teoteo/Wheelly/driver/indi-wheelly/upstream/CMakeLists-indi.txt

# SPDX-FileCopyrightText: 2026 Matteo Beretta
# SPDX-License-Identifier: LGPL-2.1-or-later
#
# The lines to_indi.py appends to indilib/indi's drivers/filter_wheel/
# CMakeLists.txt - everything from the banner below to the end of this file.
# The @...@ fields are filled by to_indi.py from this folder's CMakeLists.txt,
# so the version proposed to INDI cannot fall behind the driver's own. Not
# used by this repository's build.
#
# Modelled on the filter wheels already there - xagyl_wheel, rasa_filtercube:
# one executable linked to indidriver, installed to bin - and on the Shelyak
# driver in drivers/spectrograph/, which keeps its sources in a subfolder and
# names them from the category's CMakeLists.txt, without a CMakeLists.txt of
# its own. A subfolder because the driver brings its own protocol header and
# a configured header template, which belong together and would be the only
# ones of their kind loose in a folder shared by fifteen drivers.

# ############### Wheelly Filter Wheel ################
set(WHEELLY_VERSION_MAJOR @WHEELLY_VERSION_MAJOR@)
set(WHEELLY_VERSION_MINOR @WHEELLY_VERSION_MINOR@)
set(WHEELLY_DEVICE_NAME "Wheelly")
configure_file(${CMAKE_CURRENT_SOURCE_DIR}/wheelly/wheelly_config.h.cmake
               ${CMAKE_CURRENT_BINARY_DIR}/wheelly/wheelly_config.h)

SET(wheelly_SRC
    ${CMAKE_CURRENT_SOURCE_DIR}/wheelly/wheelly.cpp)

add_executable(@WHEELLY_EXECUTABLE@ ${wheelly_SRC})
target_include_directories(@WHEELLY_EXECUTABLE@ PRIVATE
    ${CMAKE_CURRENT_SOURCE_DIR}/wheelly
    ${CMAKE_CURRENT_BINARY_DIR}/wheelly)
target_link_libraries(@WHEELLY_EXECUTABLE@ indidriver)
install(TARGETS @WHEELLY_EXECUTABLE@ RUNTIME DESTINATION bin)
