teoteo/Wheelly/brand/png/wheelly-mark-3x.png

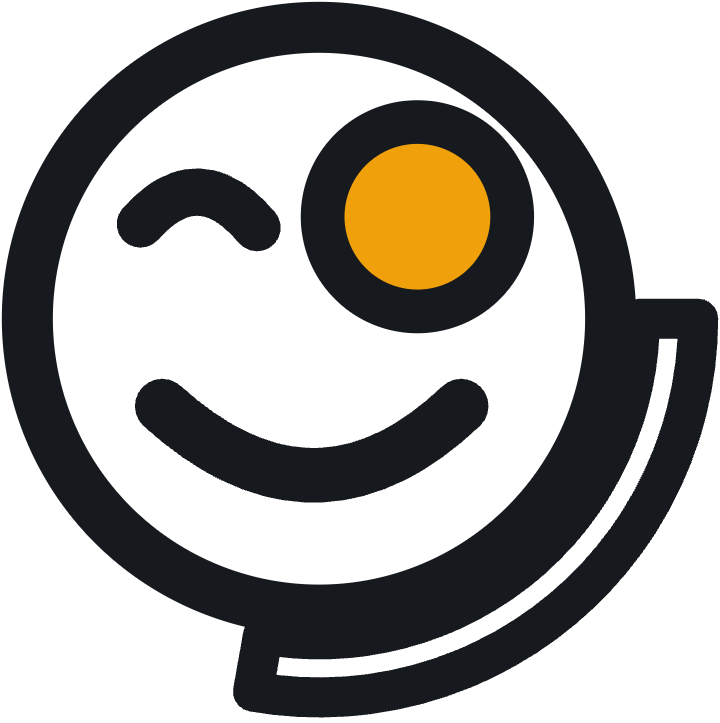
brand/png/wheelly-mark-3x.png
