teoteo/Wheelly/brand/png/wheelly-mark-mono-paper-3x.png

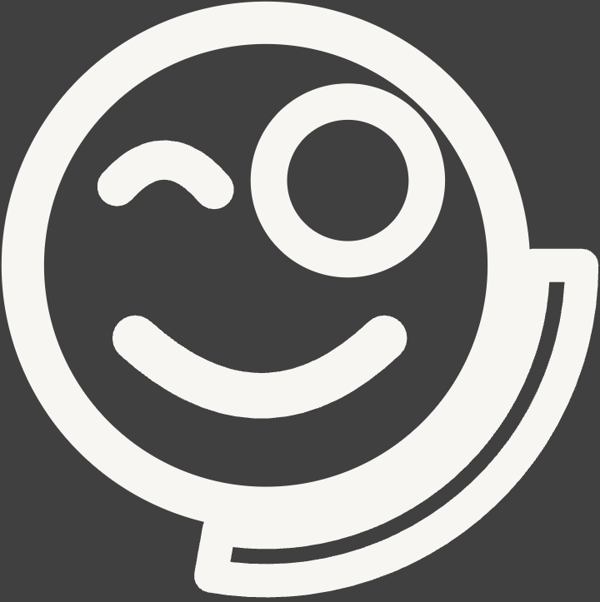
brand/png/wheelly-mark-mono-paper-3x.png
