teoteo/Wheelly/brand/png/wheelly-mark-reversed-3x.png

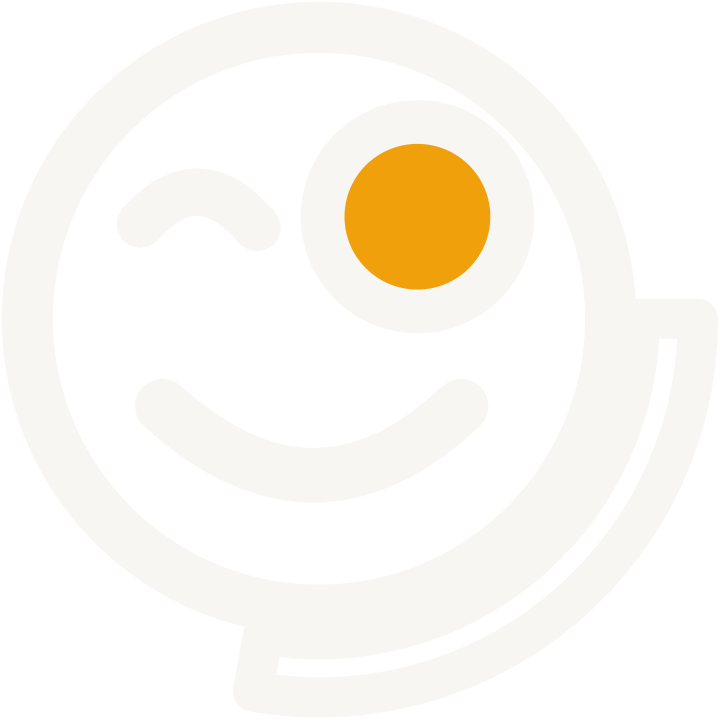
brand/png/wheelly-mark-reversed-3x.png
