teoteo/Wheelly/driver/indi-wheelly/upstream/doc/wheelly.webp

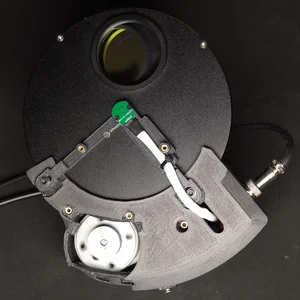
driver/indi-wheelly/upstream/doc/wheelly.webp
