teoteo/Wheelly/docs/assembly/README.md

<!--
SPDX-FileCopyrightText: 2026 Matteo Beretta
SPDX-License-Identifier: CC-BY-4.0
-->

*[Leggi in italiano](it/README.md)*

# Wheelly — assembly guide

A motorised filter wheel, built from a manual one. Work through the chapters in order: each one lists the parts and the tools it needs before its first step.

**The published guide is the site** — open `index.html` here, or the GitHub Pages address of this repository. The Markdown files below are the same chapters, kept so they can be read and diffed inside GitHub.

Every picture in this guide is rendered from the CAD model itself, so it cannot show a machine different from the one you printed. **Each part keeps the same colour from the first step to the last.**

| | Chapter | |
|---:|---|---|
| 0 | [Parts, tools and printing](00-parts-tools-and-printing.md) | [as a page](00-parts-tools-and-printing.html) · the general bill of materials, what to print and how |
| 1 | [Making it fit your wheel](01-the-parameters-page.md) | [as a page](01-the-parameters-page.html) · the parameters page: skip it if your wheel is the reference one |
| 2 | [Heat-set inserts](02-heat-set-inserts.md) | [as a page](02-heat-set-inserts.html) · all the inserts, in the order that keeps the iron reachable |
| 3 | [The collar and its gaskets](03-collar-and-gaskets.md) | [as a page](03-collar-and-gaskets.html) |
| 4 | [The spring and the connector, before the arm](04-spring-and-connector.md) | [as a page](04-spring-and-connector.html) · with the arm in there is no room for them |
| 5 | [Arm, bearings and pivot](05-arm-bearings-and-pivot.md) | [as a page](05-arm-bearings-and-pivot.html) · in from below through the electronics opening, screw already on |
| 6 | [The clutch, before the motor](06-clutch-before-the-motor.md) | [as a page](06-clutch-before-the-motor.html) · on the shaft it is caged under the roof |
| 7 | [The motor, up into the clutch](07-motor-into-the-clutch.md) | [as a page](07-motor-into-the-clutch.html) · through the hatch; its screws go through the clutch |
| 8 | [Setting the preload](08-setting-the-preload.md) | [as a page](08-setting-the-preload.html) · once the arm is there to push against |
| 9 | [The board in its panel](09-board-in-its-panel.md) | [as a page](09-board-in-its-panel.html) · the board drops in between the two guides |
| 10 | [The wheel body](10-the-wheel-body.md) | [as a page](10-the-wheel-body.html) · it slides in sideways, and the magnet goes on first |
| 11 | [Setting the air gap](11-setting-the-air-gap.md) | [as a page](11-setting-the-air-gap.html) · measured and not calculated: the glue is in the stack |
| 12 | [The sensor, and closing up](12-sensor-and-closing-up.md) | [as a page](12-sensor-and-closing-up.html) · the bracket reaches over the wheel, so it goes on last |
| 13 | [First checks](13-first-checks.md) | [as a page](13-first-checks.html) · before you put it on a telescope |
