teoteo/Wheelly/docs/assembly/it/README.md

<!--
SPDX-FileCopyrightText: 2026 Matteo Beretta
SPDX-License-Identifier: CC-BY-4.0
-->

*[Read in English](../README.md)*

# Wheelly — guida di montaggio

Una ruota portafiltri motorizzata, ricavata da una manuale. Segui i capitoli in ordine: ognuno elenca i pezzi e gli attrezzi che gli servono prima del primo passo.

**La guida pubblicata è il sito**: apri `index.html` qui, oppure l'indirizzo GitHub Pages di questo repository. I file Markdown qui sotto sono gli stessi capitoli, tenuti perché si possano leggere e confrontare dentro GitHub.

Ogni immagine di questa guida è generata dal modello CAD stesso, quindi non può mostrare una macchina diversa da quella che hai stampato. **Ogni pezzo tiene lo stesso colore dal primo passo all'ultimo.**

| | Capitolo | |
|---:|---|---|
| 0 | [Pezzi, attrezzi e stampa](00-parts-tools-and-printing.md) | [come pagina](00-parts-tools-and-printing.html) · la distinta generale, cosa stampare e come |
| 1 | [Adattarlo alla tua ruota](01-the-parameters-page.md) | [come pagina](01-the-parameters-page.html) · la pagina dei parametri: saltala se la tua ruota è quella di riferimento |
| 2 | [Inserti a caldo](02-heat-set-inserts.md) | [come pagina](02-heat-set-inserts.html) · tutti gli inserti, nell'ordine che lascia arrivare il saldatore |
| 3 | [Il collare e le sue guarnizioni](03-collar-and-gaskets.md) | [come pagina](03-collar-and-gaskets.html) |
| 4 | [La molla e il connettore, prima del braccio](04-spring-and-connector.md) | [come pagina](04-spring-and-connector.html) · con il braccio montato non c'è più spazio per loro |
| 5 | [Braccio, cuscinetti e perno](05-arm-bearings-and-pivot.md) | [come pagina](05-arm-bearings-and-pivot.html) · dal basso attraverso l'apertura dell'elettronica, con la vite già montata |
| 6 | [La frizione, prima del motore](06-clutch-before-the-motor.md) | [come pagina](06-clutch-before-the-motor.html) · sull'albero resta chiusa sotto il tetto |
| 7 | [Il motore, su dentro la frizione](07-motor-into-the-clutch.md) | [come pagina](07-motor-into-the-clutch.html) · attraverso la botola; le sue viti passano dentro la frizione |
| 8 | [Regolare il precarico](08-setting-the-preload.md) | [come pagina](08-setting-the-preload.html) · quando c'è il braccio contro cui spingere |
| 9 | [La basetta nel pannellino](09-board-in-its-panel.md) | [come pagina](09-board-in-its-panel.html) · la basetta scende fra le due guide |
| 10 | [Il corpo della ruota](10-the-wheel-body.md) | [come pagina](10-the-wheel-body.html) · entra di fianco, e il magnete va messo prima |
| 11 | [Regolare il traferro](11-setting-the-air-gap.md) | [come pagina](11-setting-the-air-gap.html) · misurato e non calcolato: nella pila c'è anche la colla |
| 12 | [Il sensore, e si chiude](12-sensor-and-closing-up.md) | [come pagina](12-sensor-and-closing-up.html) · la staffa scavalca la ruota, quindi va montata per ultima |
| 13 | [Prime verifiche](13-first-checks.md) | [come pagina](13-first-checks.html) · prima di metterla su un telescopio |
