teoteo/Wheelly/docs/assembly/02-heat-set-inserts.md

<!--
SPDX-FileCopyrightText: 2026 Matteo Beretta
SPDX-License-Identifier: CC-BY-4.0
-->

*[Leggi in italiano](it/02-heat-set-inserts.md)*

# Chapter 2 — Heat-set inserts

*The published version of this chapter, with pictures side by side and a pinned table of contents, is in [the guide](02-heat-set-inserts.html).*

Before anything is assembled, the printed parts get their brass inserts. Doing them all in one sitting is not just convenience: some of them can only be reached while the part is bare, and the pivot insert is the clearest case - once the arm hangs on that pivot, no soldering iron will ever reach it again. The clutch&#x27;s insert goes in here too, last.

## What this chapter needs

| Qty | Part | |
|---:|---|---|
| 1 | box and collar | printed, ASA |
| 1 | M3 insert · pivot | M3 heat-set insert, Ø5.0 × 3.0 mm **M** |
| 3 | M3 insert · panel screw | M3 heat-set insert, Ø5.0 × 3.0 mm **M** |
| 2 | M3 insert · hatch cover | M3 heat-set insert, Ø5.0 × 3.0 mm **M** |
| 2 | M3 insert · grip cover | M3 heat-set insert, Ø5.0 × 3.0 mm **M** |
| 1 | M4 insert · preload screw | M4 heat-set insert, Ø6.3 × 8.1 mm **M** |
| 1 | board panel | printed, ASA |
| 2 | M2 insert · board post | M2 heat-set insert, Ø3.6 × 4.0 mm **M** |
| 1 | M2.5 insert · board post, head end | M2.5 heat-set insert, Ø4.6 × 4.0 mm **M** |
| 1 | sensor bracket | printed, ASA |
| 2 | M2.5 insert · sensor cover | M2.5 heat-set insert, Ø4.6 × 4.0 mm **M** |
| 1 | clutch hub | printed, ASA |
| 1 | clutch tyre | printed, TPU 87A-95A |
| 1 | M3 insert · clutch grub screw | M3 heat-set insert, Ø5.0 × 3.0 mm **M** |

**Tools:** soldering iron with heat-set tips for <b>M2</b>, <b>M2.5</b>, <b>M3</b> and <b>M4</b> inserts, a square block to press against, or a steady hand.

<table><tr>
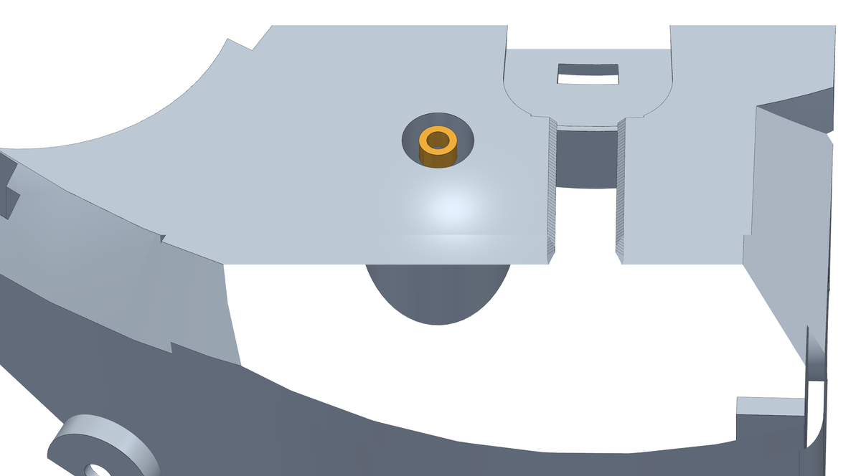
[picture p27: docs/assembly/img/02-01-heat-set-inserts.png]
The collar: the pivot insert, first of all
<td width="55%"></td>
<td valign="top"><h3>Step 1 — The collar: the pivot insert, first of all</h3><ul><li>Put the collar in front of you with the telescope side up - the side the pivot boss is on.</li><li>Melt the <b>Ø5.0 × 3.0 mm</b> <b>M3</b> insert into the end of the pivot, flush with the face around it.</li><li><b>Careful:</b> Do this one before the others and before anything else is assembled. The arm hangs on this pivot and the screw that holds it comes from the far side: once the collar is on the wheel there is no way back to this hole.</li><li>Keep the iron straight along the pivot. The hole is on the axis of a Ø5 mm post, and an insert that goes in crooked takes the screw crooked with it.</li></ul></td>
</tr></table>

<table><tr>
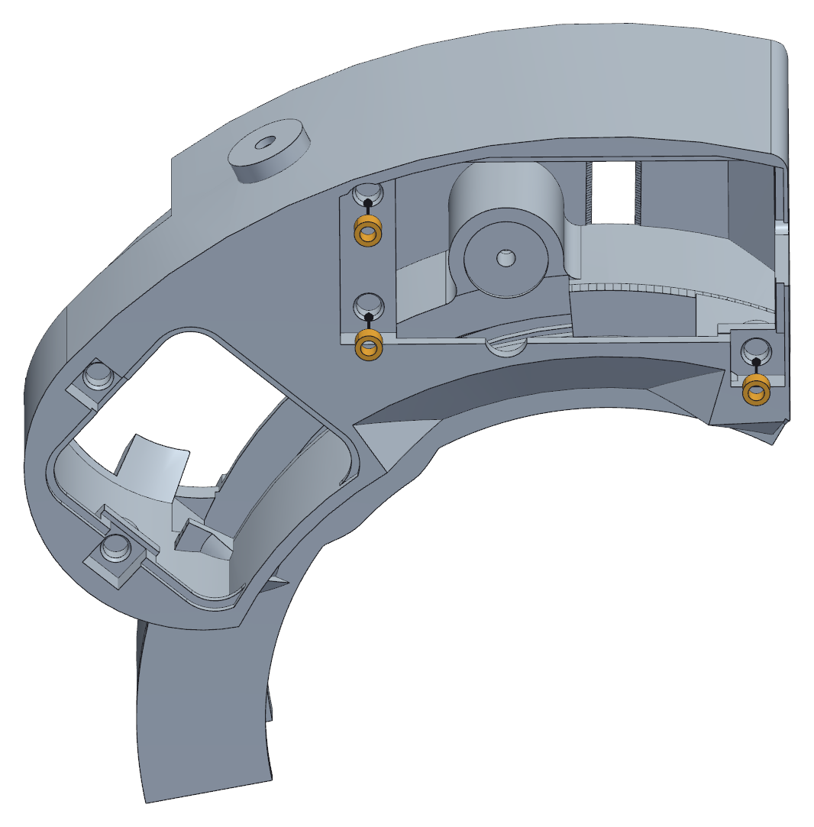
[picture p28: docs/assembly/img/02-02-heat-set-inserts.png]
The box: three inserts for the panel screws
<td width="55%"></td>
<td valign="top"><h3>Step 2 — The box: three inserts for the panel screws</h3><ul><li>The box takes three <b>M3</b> inserts, all on the outside face around the panel opening.</li><li>Same <b>Ø5.0 × 3.0 mm</b> inserts again.</li><li>The panel screws are countersunk and pull the panel flat against this face, so what matters here is that the inserts end up flush and not proud.</li></ul></td>
</tr></table>

<table><tr>
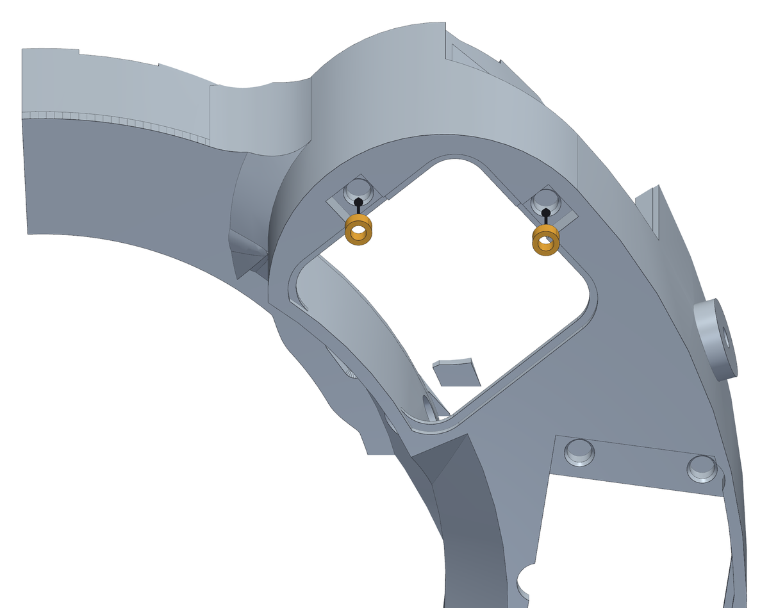
[picture p29: docs/assembly/img/02-03-heat-set-inserts.png]
The box: two inserts for the motor hatch
<td width="55%"></td>
<td valign="top"><h3>Step 3 — The box: two inserts for the motor hatch</h3><ul><li>Two more <b>Ø5.0 × 3.0 mm</b> <b>M3</b> inserts, on the outside face of the floor, in the two pockets beside the square hatch under the motor.</li><li>They go in from below, like the panel ones, and end flush with the ceiling of their pocket: the hatch cover&#x27;s two ears sit in those pockets and its countersunk screws pull them flat.</li></ul></td>
</tr></table>

<table><tr>
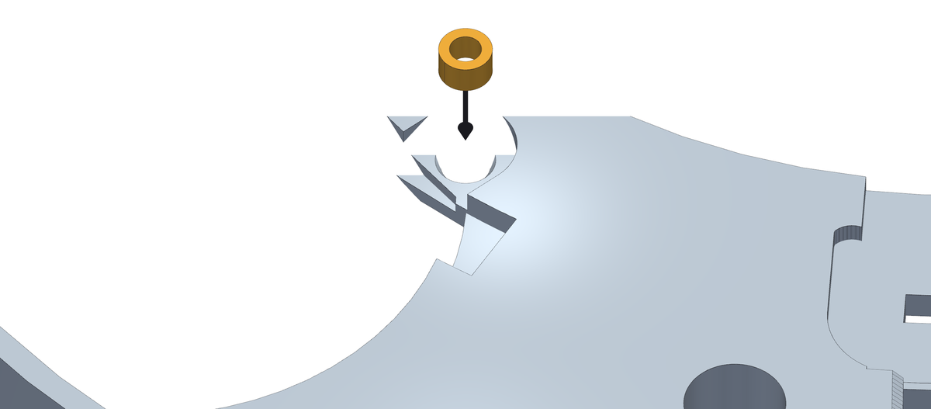
[picture p30: docs/assembly/img/02-04-heat-set-inserts.png]
The collar: the insert for the cover screw
<td width="55%"></td>
<td valign="top"><h3>Step 4 — The collar: the insert for the cover screw</h3><ul><li>One more <b>Ø5.0 × 3.0 mm</b> <b>M3</b> insert, into the small round pocket in the top of the collar, beside the big opening over the motor.</li><li>It goes in from above, straight down, flush with the floor of the pocket. The cover&#x27;s tab sits in that pocket and its screw comes down into this insert.</li></ul></td>
</tr></table>

<table><tr>
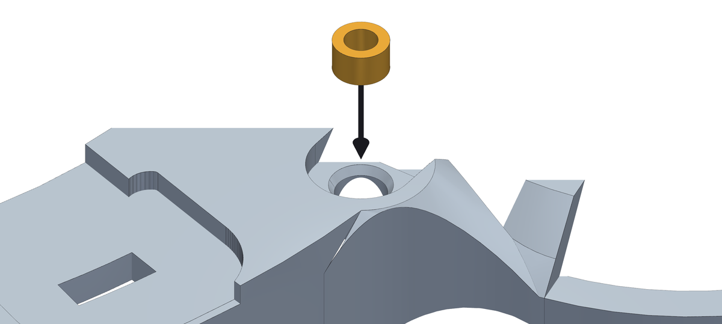
[picture p31: docs/assembly/img/02-05-heat-set-inserts.png]
The collar: the insert for the second cover screw
<td width="55%"></td>
<td valign="top"><h3>Step 5 — The collar: the insert for the second cover screw</h3><ul><li>A second <b>Ø5.0 × 3.0 mm</b> <b>M3</b> insert for the cover, in the other small round pocket in the top of the collar: the one at the corner where the collar meets the curved wall round the motor, on the side away from the electronics.</li><li>Straight down like the first, flush with the floor of the pocket.</li></ul></td>
</tr></table>

<table><tr>
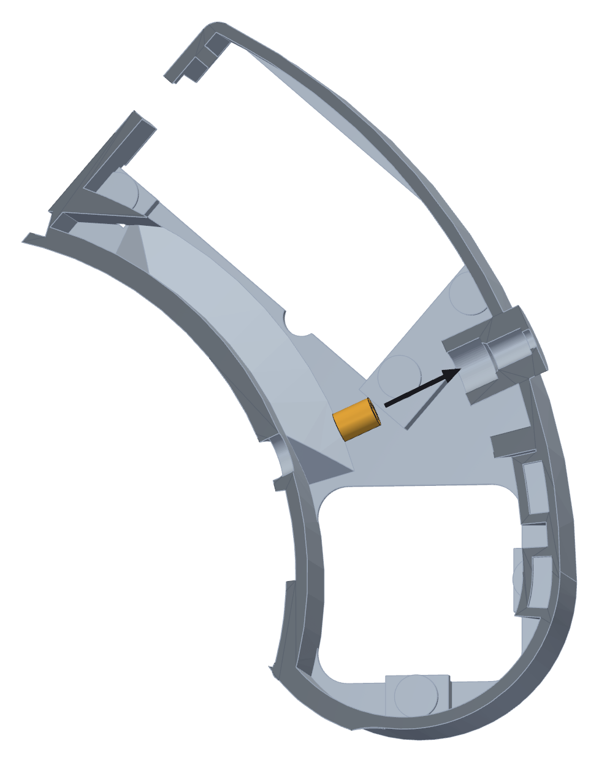
[picture p32: docs/assembly/img/02-06-heat-set-inserts.png]
The box: the M4 insert for the preload screw
<td width="55%"></td>
<td valign="top"><h3>Step 6 — The box: the M4 insert for the preload screw</h3><ul><li>One more goes into the box, and it is the odd one: an <b>M4</b> insert, <b>Ø6.3 × 8.1 mm</b>, into the outer wall behind the spring seat.</li><li>It goes in <b>horizontally, from inside the box</b>, along the axis of the spring: the iron comes across the compartment from the wheel side, through the small round hole in the inner wall, and pushes the insert out towards the outer wall. Keep the iron level. (If your insert tip is too short to reach - on the reference build the 8 mm one was - use a nail instead, heated with the iron: that is how this insert went in.)</li><li><b>Careful:</b> This is the insert the preload grub screw lives in, and the spring pushes on it with 13.5 N for the life of the machine. It is worth the extra minute of getting it square.</li></ul></td>
</tr></table>

<table><tr>
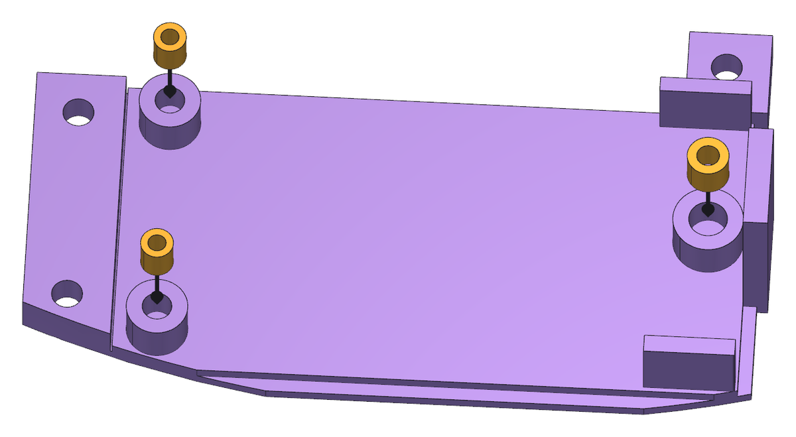
[picture p33: docs/assembly/img/02-07-heat-set-inserts.png]
The panel: three small inserts for the board
<td width="55%"></td>
<td valign="top"><h3>Step 7 — The panel: three small inserts for the board</h3><ul><li>The board panel takes three inserts on its inside face, on top of the posts the board will sit on.</li><li>Two are <b>M2</b>, <b>Ø3.6 × 4.0 mm</b>, and the one at the head end is <b>M2.5</b>, <b>Ø4.6 × 4.0 mm</b>. They are not interchangeable - fit the <b>M2.5</b> tip for that one.</li><li><b>Careful:</b> These are small. Let the iron do the work and stop as soon as the brass is level with the post: a post pushed too far melts short, and the board then sits on the panel instead of on the posts.</li></ul></td>
</tr></table>

<table><tr>
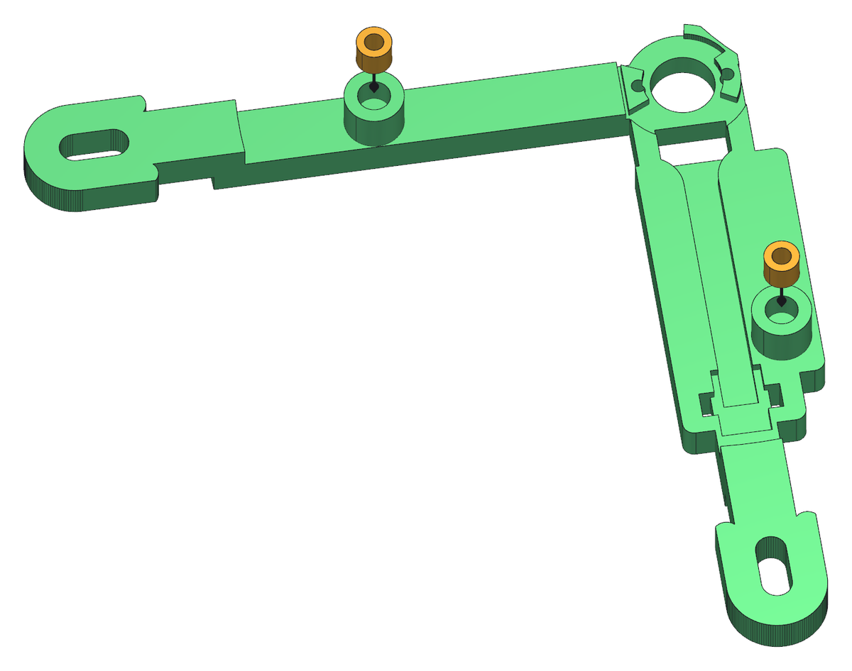
[picture p34: docs/assembly/img/02-08-heat-set-inserts.png]
The sensor bracket: two inserts for its cover
<td width="55%"></td>
<td valign="top"><h3>Step 8 — The sensor bracket: two inserts for its cover</h3><ul><li>Last, the sensor bracket: two <b>M2.5</b> inserts, <b>Ø4.6 × 4.0 mm</b>, one at each end of the cover seat.</li><li>The cover screws down onto these two and holds the sensor board against the bracket, so keep them square.</li></ul></td>
</tr></table>

<table><tr>
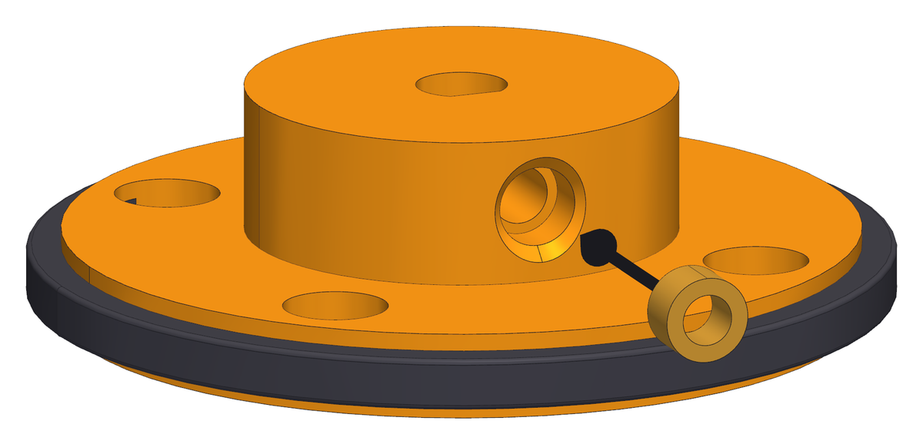
[picture p35: docs/assembly/img/02-09-heat-set-inserts.png]
The clutch: the M3 insert for its grub screw
<td width="55%"></td>
<td valign="top"><h3>Step 9 — The clutch: the M3 insert for its grub screw</h3><ul><li>Take the printed clutch - off the machine, in your hand - and find the channel in the side of the hub. It runs from the outside straight to the shaft bore.</li><li>Push the <b>Ø5.0 × 3.0 mm</b> <b>M3</b> insert into the channel with the <b>M3</b> tip, brass first.</li><li>Keep the iron in line with the channel. The channel is open all the way to the outside for that reason: the shoulders of the tyre reach Ø46 mm, and an iron coming in at an angle lands on them instead of on the insert.</li><li><b>Careful:</b> The insert stops by itself where the channel narrows into the clearance hole for the grub screw. Do not push it past that: there is no way to get it back out.</li></ul></td>
</tr></table>
