teoteo/Wheelly/docs/assembly/it/13-first-checks.md

<!--
SPDX-FileCopyrightText: 2026 Matteo Beretta
SPDX-License-Identifier: CC-BY-4.0
-->

*[Read in English](../13-first-checks.md)*

# Capitolo 13 — Prime verifiche

*La versione pubblicata di questo capitolo, con le immagini accanto al testo e l'indice sempre in vista, è nella [guida](13-first-checks.html).*

Tutto quello che segue si fa al banco, con la macchina sul tavolo e niente avvitato a un telescopio. L&#x27;ordine conta, e non solo perché ogni verifica dà per buona la precedente: ognuna <b>isola una cosa sola</b>. Quando qualcosa non va, vuoi avere davanti una causa possibile e non tre: con tre ci passi la serata, e questo progetto una serata così l&#x27;ha già spesa.

## Cosa serve per questo capitolo

| Q.tà | Pezzo | |
|---:|---|---|
| 1 | coperchio della presa | stampato, ASA |
| 2 | vite M3 · coperchio della presa, testa zigrinata | M3 × 6, testa brugola (servono 6,0 sotto testa) |

**Attrezzi:** un cavo USB-C, l&#x27;alimentatore da 12 V col suo cavo <b>GX12</b>, chiave a brugola da 2,0 mm, se il precarico va ritoccato, chiave a brugola da 2,5 mm, solo se le viti zigrinate del coperchio sono troppo strette per le dita.

<table><tr>
<td width="55%">Prima di alimentare, a occhio e col grano del precarico</td>
<td valign="top"><h3>Passo 1 — Prima di alimentare, a occhio e col grano del precarico</h3><ul><li><b>Attenzione:</b> Il disco non si gira più dal suo bordo: la frizione ora riempie la finestra da cui sporgeva il bordo zigrinato. Si gira attraverso la frizione - un pollice sul battistrada (meglio usando un guanto, per non lasciare grasso), nell&#x27;incavo sul retro della scatola che l&#x27;ultimo passo chiude - ed è quello che usa il passo 3. Questo primo passo non chiede di girare niente.</li><li>Guarda nella fessura fra collare e ruota, tutto intorno: la ruota deve essere in battuta sulla flangia dappertutto, con una fessura uniforme.</li><li>Guarda la staffa del sensore di fianco. Fra il suo tampone, sotto il coperchio, e la faccia del disco si deve vedere luce.</li><li>L&#x27;unica cosa mobile che raggiungi ancora è il precarico. Svita il grano <b>M4 × 14</b> finché la molla non è scarica, poi riavvitalo fin dov&#x27;era, sentendo il punto in cui la molla comincia a caricarsi. Deve scorrere liscio per tutta la corsa: se gratta o va a scatti, il braccio si impunta sul perno, e conviene aprire la scatola adesso piuttosto che su una montatura al buio.</li></ul></td>
</tr></table>

<h3>Passo 2 — Le due alimentazioni: quando si accendono i 12 V, e quando si spengono</h3><ul><li>La macchina ha due alimentazioni, e fanno cose diverse. La <b>USB</b> dal computer fa funzionare la scheda: firmware, sensore, LED di stato. I <b>12 V</b>, dal <b>GX12</b> sulla testata della scatola, alimentano solo il driver del motore e il motore. Tutto quello che la scheda ha da dire, lo dice con la sola USB.</li><li><b>Accesi</b> solo per far girare il motore: dal passo 4 al passo 7 qui, e sul telescopio. Prima la USB e poi i 12 V, come fa il libretto dei collegamenti; l&#x27;ordine inverso non danneggia il driver, ma così la scheda è già accesa e in ascolto quando si sveglia la parte del motore.</li><li><b>Attenzione:</b> <b>Spenti</b> - si stacca il cavo <b>GX12</b> - prima di collegare o scollegare qualunque cosa dentro la scatola, il motore prima di tutto: un passo-passo staccato da un driver alimentato lo uccide sul colpo. Spenti prima di togliere il pannellino, e spenti quando hai finito: prima i 12 V, poi la USB.</li><li>Per girare il disco a mano non serve spegnerli: a riposo il motore è rilasciato, e un pollice sulla frizione lo fa girare. Gira piano. Se hai acceso una corrente di tenuta (Opzioni), togli prima i 12 V, se no lotti contro il motore; e metti il LED su Spento se non vuoi i suoi lampeggi d&#x27;allarme - per il firmware un disco mosso a mano è una deriva.</li></ul>

<table><tr>
<td width="55%">Solo USB: la scheda si accende e legge l'angolo</td>
<td valign="top"><h3>Passo 3 — Solo USB: la scheda si accende e legge l'angolo</h3><ul><li>Collega solo la USB - la presa esce sulla testata della scatola - e lascia spenti i 12 V. Controlla che il LED di stato si accenda.</li><li>Gira piano il disco con un pollice sul battistrada della frizione, nella presa sul retro della scatola, e guarda l&#x27;angolo che riporta il sensore. Deve cambiare in modo regolare e tornare allo stesso valore sullo stesso filtro, entro una frazione di grado.</li><li><b>Attenzione:</b> Se la lettura salta o si blocca, fermati: è quasi sempre il magnete, non centrato oppure magnetizzato nello spessore invece che lungo il diametro.</li></ul></td>
</tr></table>

<h3>Passo 4 — Ora i 12 V: il chip del driver, prima che giri qualcosa</h3><ul><li>Collega i 12 V. Poi `cd firmware &amp;&amp; ./flash.sh driver_test` chiede alla scheda che cosa vede, che è più veloce di un multimetro e sbaglia meno spesso.</li><li>Risponde a due domande. La prima: <b>la UART a filo singolo fa eco?</b> Escono quattro byte e devono tornare indietro tali e quali, perché TX e RX sono uniti attraverso la resistenza da 1 kΩ, e questo vale che il chip del driver sia vivo o no. Se l&#x27;eco non c&#x27;è, il guasto è nel filo o in quella resistenza, e il driver non è ancora nemmeno sospettato.</li><li>La seconda: <b>chi risponde, e a quale indirizzo</b>. Stampa la versione del silicio: `0x20` è un TMC2208, `0x21` un TMC2209. Il firmware li accetta tutti e due.</li><li><b>Attenzione:</b> Da qui in avanti i 12 V devono essere accesi: senza, il chip è semplicemente spento e non dice niente, e quel silenzio non è un risultato.</li><li><b>Attenzione:</b> Non staccare mai il motore coi 12 V inseriti: il driver muore all&#x27;istante. Il motore si collega prima dell&#x27;alimentazione, non dopo.</li></ul>

<h3>Passo 5 — Il motore gira, e le fasi sono accoppiate giuste?</h3><ul><li>`./flash.sh motor_test` fa un giro completo in un verso e uno indietro, e a metà di ciascuno legge lo stato del driver.</li><li><b>Guarda l&#x27;albero.</b> Questo passo c&#x27;è per un guasto che nessun registro vede: le quattro uscite del driver sono due <b>coppie</b>, A con A e B con B, e se il connettore a quattro vie spezza una coppia il motore ronza, si scalda e sta fermo. Per il driver ci sono due bobine collegate, quindi non segnala niente.</li><li>Su questo motore le coppie giuste sono <b>nero+verde</b> e <b>rosso+blu</b>.</li><li>Due giri in versi opposti e la parte di potenza è a posto.</li></ul>

<h3>Passo 6 — Quanta corrente vuole la tua frizione</h3><ul><li>`./flash.sh torque_test` sale a gradini (150, 200, 250, 300, 350 mA) e a ogni gradino tiene il motore in rotazione per otto secondi, così puoi <b>frenare la frizione con la mano</b> e sentire dove smette di slittare.</li><li>Sei alla ruota e non allo schermo, quindi è il motore a dirti a che gradino è: prima di ognuno dà tanti piccoli <b>colpetti</b> quanti è il numero del gradino, da contare a orecchio o con una mano sul disco.</li><li>L&#x27;esemplare di riferimento si è fermato a <b>350 mA</b>, ed è il valore predefinito del firmware. Alla tua può bastarne meno.</li><li><b>Attenzione:</b> Si ferma apposta sotto i 400 mA di targa del motore. Se all&#x27;ultimo gradino la frizione slitta ancora, la risposta non sono gli ultimi cinquanta milliampere: è il <b>precarico della molla</b>, perché è quello a fissare la soglia di slittamento, non il motore.</li><li><b>Attenzione:</b> A 350 mA il motore consuma circa 7 W mentre si muove. Per i due secondi di un cambio filtro non è niente, perché la corrente di mantenimento è zero e a riposo il motore è rilasciato; col mantenimento attivo sarebbe un altro discorso.</li></ul>

<table><tr>
<td width="55%">Sotto tensione, una posizione alla volta</td>
<td valign="top"><h3>Passo 7 — Sotto tensione, una posizione alla volta</h3><ul><li>Con i 12 V ancora accesi, chiedi la posizione del filtro successiva. Il disco deve girare, rallentare e fermarsi nella sua posizione.</li><li>Fai il giro di tutte le posizioni due volte. La ruota prende la via più corta (il Verso di rotazione del pannello) e si avvicina a ogni posizione in pochi tratti brevi. Un movimento che invece scappa via dalla meta vuol dire che l&#x27;ordine delle fasi in J1 non è quello che si aspetta il firmware (capitolo 7); una posizione che non si raggiunge vuol dire che il motore si è bloccato o che la frizione slitta: controlla prima di tutto che il fermo della ruota sia stato tolto davvero (capitolo 10).</li><li>È la prima volta che la ruota trova le posizioni da sola, quindi guarda e ascolta per tutto il primo giro.</li><li>Se slitta, avvita il grano del precarico di un quarto di giro alla volta, non di più, e riprova.</li><li><b>Attenzione:</b> La macchina va sul telescopio solo quando tutto questo è passato. Togliere il pannellino sul tavolo è molto più facile che dietro una montatura al buio.</li><li>Finito: prima spegni i 12 V, poi la USB.</li></ul></td>
</tr></table>

<table><tr>
<td width="55%">Girala a mano, poi chiudi la presa</td>
<td valign="top"><h3>Passo 8 — Girala a mano, poi chiudi la presa</h3><ul><li>Trova l&#x27;incavo sul retro della scatola, in linea con la frizione. Il battistrada nero della frizione ne sporge di 2,0 mm: fallo rotolare col pollice e il disco gira. Poco più di mezzo giro di pollice sposta di un filtro.</li><li>Usala adesso per controllare a mano quello che hai appena visto sotto tensione, e più avanti ogni volta che filtri o treno ottico vanno puliti col treno smontato. Un breve video lo mostra: <a href="https://youtu.be/Sq2n5chqD-E">pulire i filtri a corrente spenta</a>.</li><li>Il coperchio entra <b>dall&#x27;alto</b>. Le due linguette spesse sotto il suo piede scendono nelle loro tasche in fondo all&#x27;incavo, la lingua dal lato della molla scorre giù nella scanalatura della parete di testa, il piano superiore scende nell&#x27;apertura sopra il motore e le due linguette tonde piccole nelle tasche del collare. Tutto arriva a filo col tetto della scatola.</li><li>Fissalo con due viti a brugola <b>M3 × 6</b> a testa <b>zigrinata</b>, una per ciascuna linguetta tonda piccola, negli inserti del collare. Le teste stanno sulle linguette, sopra il tetto della scatola, quindi si girano a mano. Il coperchio avvolge anche la cima della parete curva, e sono le due viti a garantire che resti chiuso.</li><li>Per toglierlo, svita le due viti con le dita (non serve la chiave), poi aggancia con l&#x27;unghia l&#x27;intaglio che attraversa la sua faccia, quello in linea con la frizione, e tira dritto verso l&#x27;alto: la faccia piana superiore dell&#x27;intaglio è quella su cui tirare.</li><li><b>Attenzione:</b> Tieni il coperchio montato tutte le volte che non stai girando la ruota a mano. L&#x27;apertura dà sulla superficie d&#x27;attrito, e la polvere che si posa lì è polvere fra la frizione e il disco.</li></ul></td>
</tr></table>
