teoteo/Wheelly/docs/assembly/it/03-collar-and-gaskets.md

<!--
SPDX-FileCopyrightText: 2026 Matteo Beretta
SPDX-License-Identifier: CC-BY-4.0
-->

*[Read in English](../03-collar-and-gaskets.md)*

# Capitolo 3 — Il collare e le sue guarnizioni

*La versione pubblicata di questo capitolo, con le immagini accanto al testo e l'indice sempre in vista, è nella [guida](03-collar-and-gaskets.html).*

Due guarnizioni in TPU tengono fuori la polvere nel punto in cui il collare incontra la ruota. Sono archi, non anelli: il collare è un arco di 130° e loro pure. Restano nelle cave grazie a piccoli bottoni che scattano nelle loro sedi. È un lavoro da banco: il collare non si avvicina alla ruota fino al capitolo 10.

## Cosa serve per questo capitolo

| Q.tà | Pezzo | |
|---:|---|---|
| 1 | guarnizione anteriore | stampato, TPU 87A-95A |
| 1 | guarnizione posteriore | stampato, TPU 87A-95A |

**Attrezzi:** le mani, nient&#x27;altro.

<table><tr>
<td width="55%">La guarnizione sul lato camera</td>
<td valign="top"><h3>Passo 1 — La guarnizione sul lato camera</h3><ul><li>Parti da un&#x27;estremità e premi la guarnizione nella cava, avanzando lungo di essa. Man mano i bottoni sotto scattano nelle loro sedi: sono loro a tenerla mentre maneggi il collare.</li><li>Il labbro guarda fuori dalla cava. La cava è larga 3,0 mm e profonda 1,5 mm, la guarnizione è larga 2,8 mm: entra senza tirarla. Se la stai tirando, è montata al contrario.</li><li>A guarnizione in sede, il labbro sporge di 0,5 mm dalla faccia. Quel mezzo millimetro è lo schiacciamento: è quello che fa tenuta quando alla fine infili il corpo della ruota.</li><li>Le guarnizioni sono in TPU; lo schiacciamento è calcolato per il 95A, e uno più morbido tiene con meno forza. Se le hai stampate a parte, sono uscite dal piatto distese, col labbro in su. Se hai una stampante multimateriale puoi invece stamparle direttamente sul collare, e allora qui non c&#x27;è niente da montare.</li></ul></td>
</tr></table>

<table><tr>
<td width="55%">E quella sul lato telescopio</td>
<td valign="top"><h3>Passo 2 — E quella sul lato telescopio</h3><ul><li>Gira il collare e ripeti nella cava sull&#x27;altra faccia.</li><li><b>Attenzione:</b> Con questa fai più attenzione. Sul lato camera ci sono due barriere in serie, questa guarnizione e una nervatura a labirinto dietro; sul lato telescopio invece la guarnizione è l&#x27;unica cosa fra la polvere e i tuoi filtri.</li><li>Alla fine passa un dito lungo tutte e due: il labbro deve sporgere uguale per tutto il giro, senza tratti più alti dove un bottone non è scattato in sede.</li></ul></td>
</tr></table>
