teoteo/Wheelly/docs/assembly/it/04-spring-and-connector.md

<!--
SPDX-FileCopyrightText: 2026 Matteo Beretta
SPDX-License-Identifier: CC-BY-4.0
-->

*[Read in English](../04-spring-and-connector.md)*

# Capitolo 4 — La molla e il connettore, prima del braccio

*La versione pubblicata di questo capitolo, con le immagini accanto al testo e l'indice sempre in vista, è nella [guida](04-spring-and-connector.html).*

Due cose entrano nella scatola prima del braccio. La molla di precarico e il suo scodellino stanno fra la loro sede nella scatola e il fianco della piastra del braccio: una volta montato il braccio, non c&#x27;è più spazio per metterli. E il connettore <b>GX12</b> e il LED di stato vanno nella testata della scatola adesso, finché niente intralcia il dado.

## Cosa serve per questo capitolo

| Q.tà | Pezzo | |
|---:|---|---|
| 1 | connettore GX12, 2 poli | presa da pannello con il suo dado, e la spina corrispondente per il cavo dei 12 V |
| 1 | D1 LED rosso, 3 mm | fuori dalla basetta; se arriva già cablato per i 12 V, togligli la resistenza |
| 1 | molla di precarico | molla di compressione, filo 0,9, Ø esterno 6,7, libera 13,5, montata 11,1, 5,7 N/mm (quella del prototipo viene da una molletta per i panni) |
| 1 | scodellino della molla | stampato, ASA |

**Attrezzi:** una chiave da 14 mm, per il dado del connettore <b>GX12</b>, un saldatore, per cablare prima il connettore e il LED.

<table><tr>
<td width="55%">Il connettore GX12, da fuori della testata</td>
<td valign="top"><h3>Passo 1 — Il connettore GX12, da fuori della testata</h3><ul><li>Cablali prima, sul banco: due fili sui pin del <b>GX12</b>, per il morsetto dei 12 V sulla scheda (J3), e due sui piedini del LED, per la sua spina <b>JST XH</b> a 2 vie (J5). Lasciali abbastanza lunghi da arrivare alla scheda: la scheda sta sul pannellino, e il pannellino si toglie verso il basso. Una volta nella testata, il saldatore non ci entra più.</li><li>La testata della scatola è la parete piana in fondo. Il connettore <b>GX12</b> entra nel suo foro da Ø12,2 mm <b>da fuori</b>, coi pin davanti, finché il corpo non appoggia sulla faccia esterna.</li><li>Tienilo lì: il dado si monta da dentro nel passo successivo.</li></ul></td>
</tr></table>

<table><tr>
<td width="55%">Il suo dado e il LED di stato, da dentro</td>
<td valign="top"><h3>Passo 2 — Il suo dado e il LED di stato, da dentro</h3><ul><li>Entra con la mano dall&#x27;apertura dell&#x27;elettronica nel fondo. Avvita il dado sul connettore da dentro e serralo contro la faccia interna della testata.</li><li>Il LED di stato sta appena sopra il connettore: spingilo nel suo foro da dentro finché il collarino non si ferma sulla parete.</li><li>Lascia dentro i fili di tutti e due abbastanza lunghi da arrivare alla scheda: la scheda sta sul pannellino, e il pannellino si toglie verso il basso, quindi quei fili devono poterlo seguire.</li></ul></td>
</tr></table>

<table><tr>
<td width="55%">La molla e lo scodellino, nella loro sede nella scatola</td>
<td valign="top"><h3>Passo 3 — La molla e lo scodellino, nella loro sede nella scatola</h3><ul><li>Trova il mozzetto dentro la scatola, sulla parete esterna, in linea col braccio. La molla ci entra <b>da dentro</b>, spinta verso l&#x27;esterno finché non va a fondo. (La molla del prototipo viene da una molletta per i panni: filo da 0,9 mm, Ø6,7 mm esterno. Va bene qualunque molla con queste misure e circa 5,7 N/mm.)</li><li>Lo scodellino va sull&#x27;estremità esterna della molla, col lato concavo verso la molla: è lì che spingerà la vite del precarico.</li><li>La scatola è capovolta e la botola sotto il motore è ancora aperta: si entra da lì. Porta su molla e scodellino attraverso la botola, avvicinali alla sede e spingili dentro lungo il suo asse.</li><li>La molla è lunga 13,5 mm libera e finirà lunga 11,1 mm a macchina montata. Adesso non regolare niente: a questo serve il grano, una volta montato il braccio (capitolo 8).</li></ul></td>
</tr></table>
