teoteo/Wheelly/docs/assembly/it/06-clutch-before-the-motor.md

<!--
SPDX-FileCopyrightText: 2026 Matteo Beretta
SPDX-License-Identifier: CC-BY-4.0
-->

*[Read in English](../06-clutch-before-the-motor.md)*

# Capitolo 6 — La frizione, prima del motore

*La versione pubblicata di questo capitolo, con le immagini accanto al testo e l'indice sempre in vista, è nella [guida](06-clutch-before-the-motor.html).*

La frizione è ciò che spinge il disco dei filtri: un mozzo stampato in ASA con attorno un battistrada in TPU co-stampato, che si fissa sulla spianatura dell&#x27;albero motore con un grano. Si monta adesso, prima del motore: una volta sull&#x27;albero non si può più sfilare, perché il tetto della scatola le sta un millimetro sopra. Quindi va messa in posizione prima, dal centro del collare, e poi il motore sale a infilarcisi. Il suo inserto c&#x27;è già, dal capitolo 2.

## Cosa serve per questo capitolo

| Q.tà | Pezzo | |
|---:|---|---|

**Attrezzi:** le mani, nient&#x27;altro.

<table><tr>
<td width="55%">Fai scivolare la frizione dal centro del collare</td>
<td valign="top"><h3>Passo 1 — Fai scivolare la frizione dal centro del collare</h3><ul><li>La ruota non è ancora montata, quindi il centro del collare è vuoto. Cala la frizione lì dentro dal lato telescopio, in piano, battistrada in giù e collarino del mozzo in su.</li><li>Falla scorrere verso l&#x27;esterno, sempre in piano, attraverso il varco nell&#x27;anello del collare, finché non sta sopra il braccio, dove salirà l&#x27;albero motore.</li><li>Girala in modo che i suoi <b>quattro fori</b> stiano sopra i quattro fori del braccio: più avanti ci passeranno le viti del motore, dall&#x27;alto.</li><li>Per ora appoggia soltanto sul braccio. Il motore ci sale dentro nel prossimo passo.</li></ul></td>
</tr></table>
