teoteo/Wheelly/docs/assembly/it/10-the-wheel-body.md

<!--
SPDX-FileCopyrightText: 2026 Matteo Beretta
SPDX-License-Identifier: CC-BY-4.0
-->

*[Read in English](../10-the-wheel-body.md)*

# Capitolo 10 — Il corpo della ruota

*La versione pubblicata di questo capitolo, con le immagini accanto al testo e l'indice sempre in vista, è nella [guida](10-the-wheel-body.html).*

Adesso la macchina va sulla ruota attorno a cui è stata costruita: una ruota portafiltri manuale da Ø158 mm. Il collare è un mezzo anello, aperto dal lato opposto alla scatola, quindi la ruota non entra lungo il suo asse: scivola dentro di lato, fra le due guarnizioni, finché il suo centro non coincide con quello del collare. Il magnete va sul disco prima, perché dopo non c&#x27;è più modo di arrivarci.

## Cosa serve per questo capitolo

| Q.tà | Pezzo | |
|---:|---|---|
| 1 | distanziale del magnete | stampato, ASA |
| 1 | magnete | Ø8 × 1, **DIAMETRALMENTE MAGNETIZZATO** |

**Attrezzi:** cianoacrilato o epossidica per il magnete, un cacciavite adatto alle viti del fermo della ruota.

<table><tr>
<td width="55%">Via il fermo, il magnete sul mozzo del disco dei filtri</td>
<td valign="top"><h3>Passo 1 — Via il fermo, il magnete sul mozzo del disco dei filtri</h3><ul><li>Con la ruota ancora in mano, fai fare al disco un giro completo: il bordo zigrinato sporge di 2 mm dalla finestra sul fianco del corpo, e il pollice serve a questo. Sentilo scattare in ogni tacca del fermo - lo scatto a molla che tiene una ruota manuale su ogni filtro - e ascolta se qualcosa si impunta.</li><li>Ora togli il fermo: svitalo dal corpo della ruota e mettilo via in un posto sicuro, con la sua molla e gli eventuali pezzetti - ti serve per usare di nuovo la ruota a mano. Poi riavvita le viti del fermo nei loro fori sul corpo, così non si perdono.</li><li><b>Attenzione:</b> Il fermo va tolto, sempre. Il motore gira il disco per attrito, attraverso la frizione, e non riesce a uscire dalle tacche: ci si blocca contro, ronzando, e la ruota non arriva mai al suo filtro. Se più avanti un movimento si blocca o slitta, il log del driver ti rimanda a questo passo.</li><li>Gira il disco ancora una volta: adesso deve girare liscio, senza scatti.</li><li><b>Attenzione:</b> È l&#x27;ultima volta che lo giri dal bordo: quella stessa finestra la occupa la frizione, e la scatola la chiude. A macchina montata il disco si gira ancora a mano dalla presa sul retro della scatola, facendo rotolare col pollice il battistrada della frizione: vedi il capitolo 13.</li><li>Ora trova il centro del disco dei filtri dal lato del telescopio. Lì va per primo il distanziale stampato da <b>Ø7,6 × 0,8 mm</b>, centrato sull&#x27;asse: stampane quattro, è un pezzo che si perde.</li><li>Il magnete da <b>Ø8 × 1 mm</b> va sul distanziale, con circa 0,5 mm di colla. Centralo: il sensore legge la direzione del campo, e un magnete fuori centro si legge come un errore che cambia con l&#x27;angolo.</li><li><b>Attenzione:</b> Il magnete deve essere magnetizzato <b>lungo il diametro</b>, non attraverso lo spessore. Uno magnetizzato assialmente è identico a vedersi, si compra per sbaglio con facilità e non dà nessuna lettura utile: e te ne accorgi solo quando è tutto montato.</li><li>Messi uno sull&#x27;altro, la faccia del magnete arriva 2,3 mm sopra la faccia del disco. Qui non c&#x27;è niente di regolabile, quindi prenditi il tempo di incollarlo in piano.</li></ul></td>
</tr></table>

<table><tr>
<td width="55%">Fai scivolare la ruota nel collare</td>
<td valign="top"><h3>Passo 2 — Fai scivolare la ruota nel collare</h3><ul><li>Tieni il braccio tirato indietro contro la molla: la frizione deve stare fuori dai piedi, perché dove sta per andare la ruota c&#x27;è già il battistrada.</li><li>Porta dentro la ruota <b>di lato</b>, dal lato aperto del collare, con il magnete rivolto verso il telescopio. I labbri delle due guarnizioni si allargano al passaggio del bordo.</li><li>Spingi finché la ruota non è in battuta contro la flangia del collare e il magnete è sull&#x27;asse. Poi lascia andare il braccio: la frizione si chiude da sola sul bordo del disco dei filtri.</li><li>Controlla a occhio, tutto intorno, che la ruota sia in battuta contro la flangia del collare e che il magnete stia sull&#x27;asse. È quello che hai al posto di girarla: la finestra da cui passava il bordo adesso è piena di frizione.</li></ul></td>
</tr></table>
