teoteo/Wheelly/brand/wheelly-brand-guide.pdf

## B R A N D G U I D E L I N E S

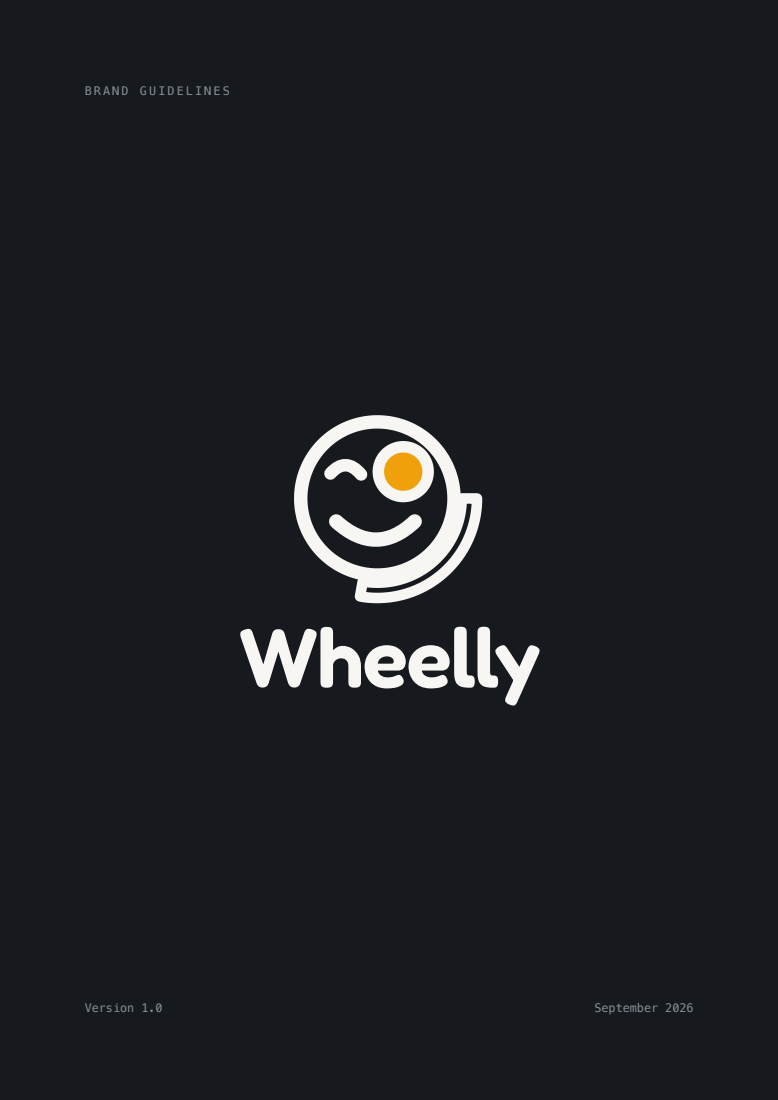
[picture p57: page 1]
Wheelly; Version 1.0; September 2026

## 0 1 — T H E M A R K

# A fi lter wheel with a wink

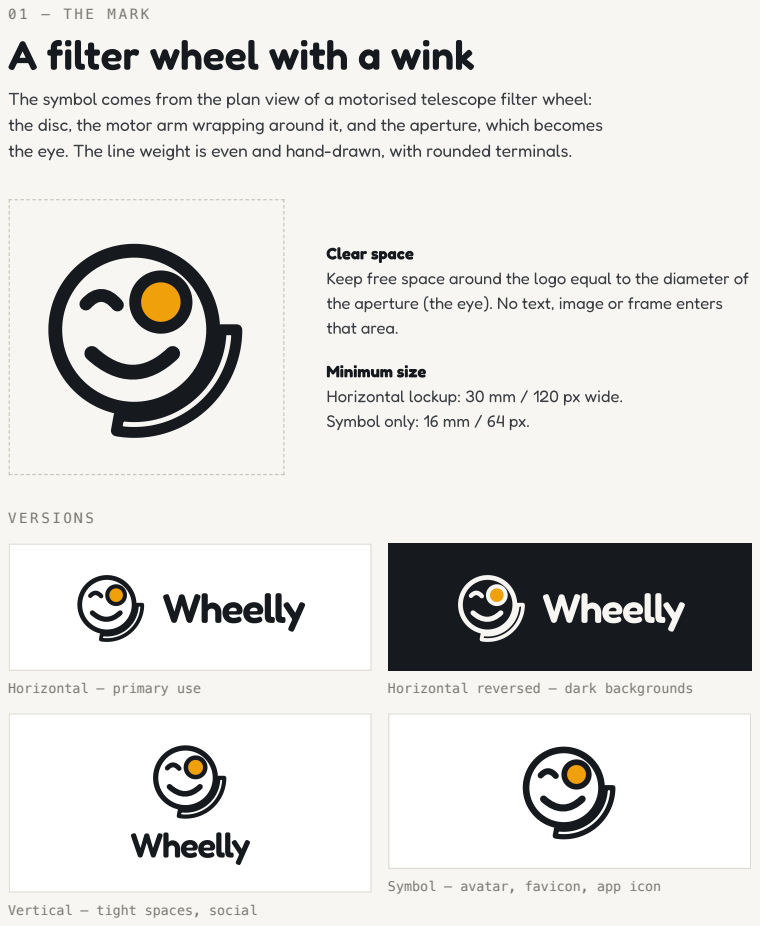
[picture p58: page 2]
Clear space; that area.; Minimum size; Wheelly

The symbol comes from the plan view of a motorised telescope fi lter wheel:

the disc, the motor arm wrapping around it, and the aperture, which becomes

the eye. The line weight is even and hand-drawn, with rounded terminals.

Keep free space around the logo equal to the diameter of

the aperture (the eye). No text, image or frame enters

Horizontal lockup: 30 mm / 120 px wide.

Symbol only: 16 mm / 64 px.

Horizontal — primary use

Horizontal reversed — dark backgrounds

Symbol — avatar, favicon, app icon

Vertical — tight spaces, social

## 0 2 — C O L O U R A N D T Y P E

# Three colours, one typeface

## Ink

#16191D

## RGB 22 25 29 Linework, type

### Amber

## EFA00B RGB 239 160 11 The eye, accents only

### Paper

## F7F6F3 RGB 247 246 243 Light background

## F R E D O K A

# Wheelly

## ABCDEFGHIJKLMNOPQRSTUVWXYZ

## abcdefghijklmnopqrstuvwxyz 0123456789

Logotype

Fredoka SemiBold 600

tracking −1 px

Headings

Fredoka Medium 500

Body

Fredoka Regular 400

## 0 3 — M I S U S E

# What not to do

The mark is always used as supplied. If a background makes it hard to read,

switch to the reversed version rather than altering the artwork. The wordmark

is never used on its own: it always travels with the symbol.

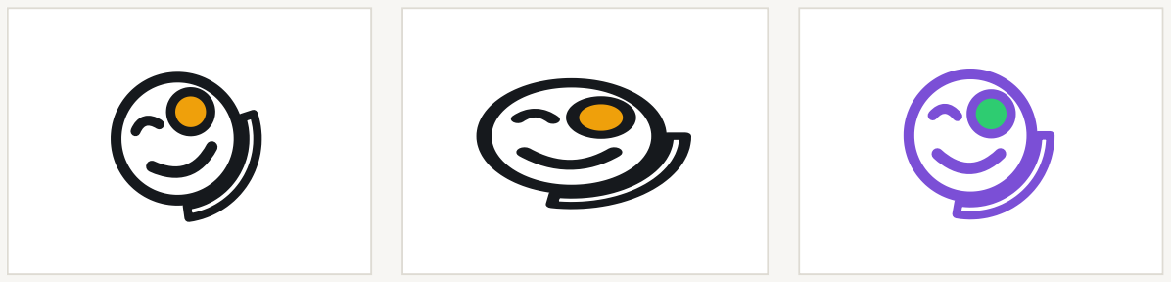
[picture p59: figure]

Do not rotate or tilt the mark. | Do not stretch or squash it. | Do not recolour the linework or
| | the eye.

Do not place the mark on low-

contrast backgrounds.

Do not add shadows, glows or

outlines.

# Wheelly

Do not set the name in another

typeface.

Wheelly brand guidelines | Version 1.0 — September 2026
