teoteo/Wheelly/mechanics/wheelly-cad/src/guide/it/clutch_before_the_motor.py

# SPDX-FileCopyrightText: 2026 Matteo Beretta
# SPDX-License-Identifier: CERN-OHL-P-2.0
"""Italian catalogue for the chapter 'clutch-before-the-motor'."""

CATALOGUE = {
    'clutch-before-the-motor/title': ('20073748',
        'La frizione, prima del motore'),
    'clutch-before-the-motor/intro': ('5ab8a3a0',
        "La frizione è ciò che spinge il disco dei filtri: un mozzo stampato in ASA con attorno un battistrada in TPU co-stampato, che si fissa sulla spianatura dell'albero motore con un grano. Si monta adesso, prima del motore: una volta sull'albero non si può più sfilare, perché il tetto della scatola le sta un millimetro sopra. Quindi va messa in posizione prima, dal centro del collare, e poi il motore sale a infilarcisi. Il suo inserto c'è già, dal capitolo {cap_heat_set_inserts}."),
    'clutch-before-the-motor/tool1': ('ba2be246',
        "le mani, nient'altro"),
    'clutch-before-the-motor/1/title': ('130aa9ee',
        'Fai scivolare la frizione dal centro del collare'),
    'clutch-before-the-motor/1/point1': ('bcb643df',
        'La ruota non è ancora montata, quindi il centro del collare è vuoto. Cala la frizione lì dentro dal lato telescopio, in piano, battistrada in giù e collarino del mozzo in su.'),
    'clutch-before-the-motor/1/point2': ('33849658',
        "Falla scorrere verso l'esterno, sempre in piano, attraverso il varco nell'anello del collare, finché non sta sopra il braccio, dove salirà l'albero motore."),
    'clutch-before-the-motor/1/point3': ('4227635c',
        "Girala in modo che i suoi **quattro fori** stiano sopra i quattro fori del braccio: più avanti ci passeranno le viti del motore, dall'alto."),
    'clutch-before-the-motor/1/point4': ('f8b8d9ef',
        'Per ora appoggia soltanto sul braccio. Il motore ci sale dentro nel prossimo passo.'),
}
