teoteo/Wheelly/mechanics/wheelly-cad/src/solids_box_collar.py

# -*- coding: utf-8 -*-
# SPDX-FileCopyrightText: 2026 Matteo Beretta
# SPDX-License-Identifier: CERN-OHL-P-2.0

"""Box with two compartments: mechanical (motor, arm, spring, clutch) and electronic.

HOW IT GOES ON THE MACHINE: **as it is modelled**, that is with the floor of
the mechanical compartment (z -38, the one under the motor) on the bed. With
the electronics in the compartment, the shorter box and the opening of the
panel, the first layer measures 4,723 mm2; the numbers below are for the
earlier shape. Measured on the solid, overhangs beyond 45 degrees and contact
with the bed, in the four orientations tried:

    as modelled         12,072 mm2 of overhangs, 7,399 mm2 on the bed
    upside down         18,853 mm2, 488 mm2 on the bed
    on its side, back   13,457 mm2, ZERO contact (it touches along a line)
    on its side, open   20,231 mm2, ZERO contact

It is not only the total: as modelled the first layer is a full sector of
7,400 mm2, whereas upside down the box stands on its six ears. And the
overhangs that remain are almost all just two pieces - the roof of the
mechanical compartment (6,979 mm2) and that of the electronic compartment
(3,014), 83% of the total - which are INNER surfaces: nobody sees the marks of
the supports there and they seal nothing. It is exactly the place where
breakaway supports are fine, and indeed it prints without soluble.

The chamfers on the outer edges were REMOVED to make way for a different
edge treatment: for now the edges are sharp. The overhang count above
is the one without chamfers.

THE SHOULDER ABOVE z 16 HAS BEEN HOLLOWED OUT, and the real saving is much
smaller than a first estimate suggested: **from 126 to 120 g, that is 5.3 cm3
and 6 grams**, not 25. The estimate counted the material up
there (27.5 cm3 above z 16, of which 23.3 beyond r 96) as if it disappeared:
the roof of the compartment does not disappear, it is LOWERED. What really
goes is only the band of wall between the old roof and the new one - outer
back and two heads, measured 8.3 cm3 - less what is put back on top to carry
the ears. The right number is only obtained by building the variant and
weighing it.

The gain that remains is real all the same, and it is not the weight: the
roof to be supported - 6,881 mm2, the largest island of the part - has come
down from z 26 to z 16, so the supports under it are ten millimetres
shorter, and the solid part of the box is ten millimetres lower. The overhang
numbers above are from before the hollowing; after it they are 12,089 and
18,791, and the island of the roof is the same, only ten millimetres lower."""
import os, sys, math
sys.path.insert(0, os.path.dirname(os.path.abspath(__file__)))
OUT = os.path.join(os.path.dirname(os.path.dirname(os.path.abspath(__file__))), "out") + os.sep
os.makedirs(OUT, exist_ok=True)
import cadquery as cq
from parameters import D

# The inner face of the shell GOES INTO the collar, it leaves it no clearance:
# the two are the same part, and two solids that just touch fuse into a
# compound of two pieces instead of into one solid (see Weld_box_collar).
Ri = D["R_out_collar"] - D["Weld_box_collar"]
Ro = D["R_out_box"]          # 130
W  = D["Th_walls_box"]      # 2.5
import electronics as E
# AM0, the end of the lobe away from the pivot, is set further down: it is
# derived from the arc around the motor.
# The other end is no longer an angle: it is the HEAD WALL, a plane
# perpendicular to the board with its outer face flush with the USB socket
# (electronics.py). The electronic compartment of before, 63..108, is gone:
# the electronics sit in here. The sector is built out to beyond the head and
# then cut on the plane.
AM1 = E.head_angle(Ri, "out") + 1.0
# ZT IS NO LONGER A NUMBER. It was -38 written by hand, and when the motor
# moved - turning the clutch over - it would not have followed
# it: the floor would have stayed where it was and the millimetres gained
# would have become empty space instead of height removed.
ZT, ZB   = D["Z_floor_box"], 28.5    # ends of the mechanical compartment

# ---------------- the arc around the motor ----------------
# Beyond the shaft the back does not run on at r 130: it turns into an arc
# CENTRED ON THE MOTOR AXIS, tangent to the back on the line from the wheel
# centre through the shaft, and it runs round the motor down to the collar
# (drawn from a sketch on the top view). It replaces the old
# setback, which came back to the back at -8 degrees along a curve centred on
# nothing in particular: the box now wraps only what it holds.
#
# HOW IT IS BUILT, and why not as a radius that varies with the angle, which is
# how the setback was done. Rays from the wheel centre beyond -19.5 degrees
# miss the arc altogether, so "the radius of the back at this angle" has no
# answer there; and a radius sampled every half degree is a polyline, not an
# arc. So every region that used to reach "the back minus an offset" is now the
# sector up to Ro - offset INTERSECTED with what the arc keeps at that same
# offset (_keep): the half plane on the pivot side, plus the disc about the
# shaft of radius R_arc_back_box - offset. Both boundaries are true arcs, and
# because the arc is tangent to the back, every offset is tangent too - the
# wall is born with its thickness, like the setback's was.
MX, MY = D["Cd_motor"], 0.0
RA = D["R_arc_back_box"]
# where the arc meets a circle of radius r about the wheel centre, on the side
# away from the pivot: the angle at which the lobe ends at that radius
def arc_angle(r, off=0.0):
    _ra = RA - off
    _x = (r*r - _ra*_ra + MX*MX) / (2*MX)
    return -math.degrees(math.acos(max(-1.0, min(1.0, _x / r))))


def _keep(off, z0=-100.0, h=200.0):
    """What the arc keeps, at `off` inside the outer skin: the half plane on the
    pivot side (y >= 0) plus the disc about the shaft of radius RA - off."""
    _half = cq.Solid.makeBox(400.0, 200.0, h, cq.Vector(-200.0, 0.0, z0))
    _disc = cq.Solid.makeCylinder(RA - off, h, cq.Vector(MX, MY, z0))
    return cq.Workplane(obj=_half.fuse(_disc))


def back_radius(a):
    """The radius of the back at that angle: 130, or the far point of the arc.
    Only meaningful from arc_angle(Ri) upwards - below it the lobe has ended.
    Used by the grip, which lives within a few degrees of the shaft line."""
    if a >= 0.0:
        return Ro
    _c = MX*math.cos(math.radians(a))
    _d = RA*RA - MX*MX + _c*_c
    return _c + math.sqrt(_d) if _d > 0 else Ri


# The sectors are built from AM0 and then cut by the arc, so AM0 is only a
# construction bound: it must lie beyond the point where the arc reaches the
# innermost radius any region starts from (Ri - 2, the void), plus a margin.
# It used to be -30, the radial end wall of the lobe; that wall is gone.
AM0 = arc_angle(Ri - 2.0) - 3.0


def inside(a0, a1, r0, off, z, h):
    """The sector from r0 out to `off` inside the outer skin, back AND arc."""
    return sett(a0, a1, r0, Ro - off, z, h).intersect(_keep(off))


def _pxy(r, a):
    return (r*math.cos(math.radians(a)), r*math.sin(math.radians(a)))


def _arc(wp, r, a0, a1):
    """Runs along the arc of radius r from a0 to a1 with TRUE ARCS, broken into
    stretches of no more than ninety degrees because beyond half a turn an arc
    through three points is no longer determined."""
    n = max(1, int(math.ceil(abs(a1 - a0)/90.0)))
    for i in range(n):
        b0 = a0 + (a1 - a0)*i/n
        b1 = a0 + (a1 - a0)*(i + 1)/n
        wp = wp.threePointArc(_pxy(r, (b0 + b1)/2), _pxy(r, b1))
    return wp


def sett(a0, a1, r0, r1, z, h, step=0.5):
    """Sector between two radii. r0 and r1 can be numbers or functions of the
    angle: that is how the back steps in without needing cuts."""
    if not (callable(r0) or callable(r1)):
        # constant radii: TRUE ARCS, so the curved face is one face instead
        # of a fan of flat faces. The same reason written next to the
        # collar's sett() applies.
        wp = cq.Workplane("XY").workplane(offset=z).moveTo(*_pxy(r1, a0))
        wp = _arc(wp, r1, a0, a1)
        if abs(r0) < 1e-9:
            wp = wp.lineTo(0.0, 0.0)
        else:
            wp = wp.lineTo(*_pxy(r0, a1))
            wp = _arc(wp, r0, a1, a0)
        return wp.close().extrude(h)
    n = max(2, int((a1-a0)/step)+1)
    A = [a0 + (a1-a0)*i/(n-1) for i in range(n)]
    f1 = r1 if callable(r1) else (lambda a: r1)
    f0 = r0 if callable(r0) else (lambda a: r0)
    p = [(f1(a)*math.cos(math.radians(a)), f1(a)*math.sin(math.radians(a))) for a in A]
    p += [(f0(a)*math.cos(math.radians(a)), f0(a)*math.sin(math.radians(a))) for a in reversed(A)]
    return cq.Workplane("XY").workplane(offset=z).polyline(p).close().extrude(h)

def beyond_head(t, z0=-60.0, h=120.0):
    """Everything that lies beyond the plane t of the head."""
    return cq.Workplane(obj=cq.Solid.makeBox(400.0, 200.0, h, cq.Vector(-100.0, t, z0))
                        .rotate(cq.Vector(0, 0, 0), cq.Vector(0, 0, 1), E.A_BOARD))


def slot_st(s_c, width, z0, z1, t0, t1, r):
    """A slot in the board frame, ROUNDED at the top and open at the bottom:
    it is the profile of the USB-C socket, which has no sharp corners
    (the opening follows the connector's outline). The radius is half the height of the SOCKET, not of
    the slot, which at the bottom runs on down to the floor because the socket
    goes into it rising together with the panel."""
    body = cq.Solid.makeBox(width, t1-t0, (z1-r)-z0, cq.Vector(s_c-width/2, t0, z0))
    body = body.fuse(cq.Solid.makeBox(width - 2*r, t1-t0, z1-z0,
                                        cq.Vector(s_c-width/2+r, t0, z0)))
    for _sg in (-1, 1):
        body = body.fuse(cq.Solid.makeCylinder(
            r, t1-t0, cq.Vector(s_c + _sg*(width/2 - r), t0, z1-r), cq.Vector(0, 1, 0)))
    return cq.Workplane(obj=body.rotate(cq.Vector(0, 0, 0), cq.Vector(0, 0, 1), E.A_BOARD))


def rect_st(s0, s1, t0, t1, z, h):
    """A rectangular prism in the board frame."""
    return cq.Workplane(obj=cq.Solid.makeBox(s1-s0, t1-t0, h, cq.Vector(s0, t0, z))
                        .rotate(cq.Vector(0, 0, 0), cq.Vector(0, 0, 1), E.A_BOARD))


def cyl(r, h, pnt, dirv):
    return cq.Workplane(obj=cq.Solid.makeCylinder(r, h, cq.Vector(*pnt), cq.Vector(*dirv)))

def pol(r, a):
    return (r*math.cos(math.radians(a)), r*math.sin(math.radians(a)))

# ---------------- shell ----------------
# The mechanical compartment no longer rises all the way to the top: it closes
# at Z_shoulder_box and above it there is only a low wall carrying the three
# rear ears.
#
# Why it can. Inside the compartment the tallest thing is the hub of the
# clutch, which ends at z 13; above it, measured on the assembly body by body,
# there was nothing else but the walls of the box. The shoulder above z 16
# weighed 27.5 cm3, of which 23.3 beyond r 96 held up nothing.
#
# And it can also because that volume faces the CLUTCH compartment, not the
# electronic one: the electronic compartment ends at z 2, fourteen millimetres
# lower, and that of the electronic compartment is the only envelope the model
# does not know everything about - the perfboard and the modules are not in
# it. Here instead the model is complete (motor, arm, clutch, spring, spring
# cup, washer, collar) and the measurement holds. Measured by sector: 99.5% of
# the material above z 16 lies in the mechanical sector, and the rest is a
# rear ear, which stays.
#
# Why the ears cannot come down with the shoulder: it is the three at the
# front AGAINST the three at the back, 29 mm apart, that make the couple that
# takes the moment of the spring. Lowering them would mean shortening the arm
# of the couple, that is increasing the pull on the screws.
# And why above the shoulder there remain three small PILLARS and not a
# continuous wall: because the roof of the compartment does not disappear, it
# is lowered. What is really saved is the band of wall between the old roof
# and the new one - the outer back and the two heads, measured 8.3 cm3 - and a
# continuous wall six millimetres wide weighs as much: done that way, the part
# would not have lost a gram. The pillars stand only where they are needed,
# under the three ears.
Qsp = D["Z_shoulder_box"]


# ---------------- the chamfer along the top outer edge ----------------
# Once the roof is flush with the collar, the 3.5 mm it
# rose make room inside, and a Ch_roof_box x Ch_roof_box chamfer along the
# whole edge where the outer wall meets the roof saves material and looks
# better. "The whole edge" is three stretches, one shape each: the back (a
# cone about the wheel axis), the arc round the motor (a cone about the shaft)
# and the head (an inclined plane). All three at 45 degrees.
#
# IT IS A WALL, NOT A CUT. Like the arc, the chamfer is applied at two
# offsets: the outer skin at 0, the void at W. The inclined face inside is
# parallel to the one outside and one wall thickness from it, so the corner
# is born as a 2.5 mm sloping wall. Cutting the outside only would have left
# the corner solid - no material saved - or, cut deeper, a wall thinning to
# nothing along the crease.
#
# Why the two cones stay tangent at every height: the arc is tangent to the
# back because Ro - RA equals the distance between the two centres. Both cones
# lose the same radius per millimetre of height, so that difference - and the
# tangency - holds at every z.
#
# A 45 degree slope facing up prints without supports: the box prints roof up.
CH = D["Ch_roof_box"]
Z_ROOF = Qsp + W


def chamfer(off):
    """What the chamfer keeps, `off` inside the outer skin: below the start of
    the slope everything, above it the three 45 degree faces moved in by off.

    Moving a 45 degree face in by `off` along its normal is the same as moving
    its start down by off*(sqrt(2) - 1) while also moving the vertical face in
    by off: that is the z0 below."""
    z0 = Z_ROOF - CH + off - off*math.sqrt(2.0)
    zt = 80.0                                          # well above anything
    def _cone(cx, cy, r):
        # a cylinder up to z0, then a cone losing one mm of radius per mm;
        # stopped half a millimetre short of its apex for the small one
        h = min(zt - z0, r - 0.5)
        return (cq.Solid.makeCylinder(r, z0 + 100.0, cq.Vector(cx, cy, -100.0))
                .fuse(cq.Solid.makeCone(r, r - h, h, cq.Vector(cx, cy, z0))))
    back = _cone(0.0, 0.0, Ro - off)
    arc = (cq.Solid.makeBox(400.0, 200.0, 200.0, cq.Vector(-200.0, 0.0, -100.0))
            .fuse(_cone(MX, MY, RA - off)))
    # the head, in the board frame (s along U, t along V), extruded along s
    t1 = E.T_HEAD_OUT - off
    prof = [(-300.0, -100.0), (t1, -100.0), (t1, z0), (t1 - (zt - z0), zt), (-300.0, zt)]
    head = (cq.Workplane("YZ").workplane(offset=-300.0).polyline(prof).close()
             .extrude(600.0).val()
             .rotate(cq.Vector(0, 0, 0), cq.Vector(0, 0, 1), E.A_BOARD))
    return cq.Workplane(obj=back.intersect(arc).intersect(head))

from parameters import EARS_FRONT, EARS_REAR

# ---------------- the void of the compartment ----------------
# The void starts two millimetres FURTHER IN than the inner face of the shell,
# where there is no material to remove. Starting from the same radius, the two
# faces coincided and the subtraction left 197 laminae of zero volume at
# r 86.2: any part passing through that radius - the clutch, the collar -
# turned out to touch them, and the audit found interpenetrations of a
# hundredth of a cubic millimetre that did not exist.
_void = (inside(AM0+2, AM1+1, Ri - 2.0, W, ZT+W, Qsp-(ZT+W)).intersect(chamfer(W))
          .cut(beyond_head(E.T_HEAD_IN)))
mech = inside(AM0, AM1, Ri, 0.0, ZT, (Qsp+W)-ZT).cut(_void)
# The three pillars that carried the rear ears up to z 28.5 are gone:
# the ears went with the one-piece part, and with the roof now
# flush with the collar the pillars were three 4 mm bumps on a flat top.
box = mech.cut(beyond_head(E.T_HEAD_OUT))

# ---------------- the inner wall under the wheel ----------------
# The side of the box towards the wheel axis is no longer the INNER SKIRT at r 86 but a
# wall at r 74.4..76.9, from the floor up into the collar flange - with the
# floor strip between it and the old shell (green), the two ends closed
# (orange) and a 10 mm chamfer in the inside corner.
#
# WHY THE SKIRT WENT. It rose under the arm to half a millimetre from it and
# carved three steps round the pivot for the bearing flange, the washer and the
# screw head: the two F695ZZ sat in it as in a cup, with the pivot column 0.2
# mm above them. check_assembly_paths found the arm could not be put in, and
# no straight path (62 directions, then 162 around the best), and no path in
# two segments (162), got it home: the best still met 503 mm3. With the wall
# moved in, the arm tilted pivot-end-down on the edge of the motor face is free
# up to 8 degrees, and the box does not touch it up to 18.
#
# THE RADIUS IS DERIVED (electronics.R_INNER_WALL): the outer face stands
# Cl_wall_inner_motor inside the motor, which is what comes nearest to the
# axis below the collar. Only below the collar: above z 0 the same ring is the
# body of the wheel.
#
# HOW IT IS BUILT: the same shell and void as the bay, only starting from the
# new wall instead of from the collar, and stopping at the collar flange. The
# void stays W inside the arc round the motor and W inside the head plane, so
# the arc wall and the head wall run on inwards to meet the new wall by
# themselves: the two orange end walls are not drawn, they are the arc and the
# head continued. The shell goes Weld_box_collar into the flange, like the rest
# of the box, and the void 1 mm into it, so that no face of the void lies on
# the underside of the flange.
RP0, RP1 = E.R_INNER_WALL
_z_flange = -D["Th_flange_collar"]
_shell_in = (sett(AM0, AM1, RP0, Ri + 0.5, ZT, (_z_flange + D["Weld_box_collar"]) - ZT)
              .intersect(_keep(0.0)).cut(beyond_head(E.T_HEAD_OUT)))
_void_in = (sett(AM0 + 2, AM1 + 1, RP1, Ri + 1.0, ZT + W, (_z_flange + 1.0) - (ZT + W))
             .intersect(_keep(W)).cut(beyond_head(E.T_HEAD_IN)))
box = box.union(_shell_in.cut(_void_in))

from outline_motor import silhouette as _motor_silhouette
MOTOR_SILHOUETTE = _motor_silhouette(D["Cl_entry_motor"])
# (the chamfers of the inner wall are built further down, after the panel's
# cuts: they end at the ear of the panel, and have to know where it is)

# ---------------- the slot for the iron that plants the M4 insert ----------
# The M4 insert of the preload goes in from INSIDE the box, along its own axis,
# and the iron comes in along that same axis from the other side of the
# compartment. Lowering the spring axis to Z_axis_spring took the iron under the collar's front flange; what still stood in
# its way was the inner skirt, 18.5 mm3 of it at r 87.6, which rises to just
# under the arm. So the skirt gets a U slot there - a slit for the iron - as
# wide as the channel of the iron
# (D_tip_iron + Cl_tip_iron) and only across the skirt, where the axis crosses
# the band R_SKIRT: the channel itself, not a hand-drawn rectangle, so it
# follows the axis if the axis moves. Open at the top, it prints with nothing
# overhanging.
from parameters import spring_axis as _spring_axis_f
_Qxf, _Qyf, _nxf, _nyf, _zmf = _spring_axis_f()
def _s_at_r(r):
    """Where along the spring axis the axis is at radius r, on the crossing
    NEAR Q - Q itself sits at r 89, inside the skirt band. The other root is
    on the far side of the wheel, 180 mm away, and the first version took it."""
    _b = _Qxf*_nxf + _Qyf*_nyf
    _c = _Qxf*_Qxf + _Qyf*_Qyf - r*r
    return -_b + math.sqrt(max(_b*_b - _c, 0.0))
# The skirt is gone and what the axis crosses is now the INNER
# WALL under the wheel, which runs up into the collar: the U open at the top
# would be a slit up to the flange, open to the camera side. So it is the
# channel alone, a round hole through the wall - short, 2.5 mm, and it prints
# as a bridge of a few millimetres.
_s_g0, _s_g1 = _s_at_r(E.R_INNER_WALL[1] + 1.5), _s_at_r(E.R_INNER_WALL[0] - 1.5)
_r_chan = (D["D_tip_iron"] + D["Cl_tip_iron"])/2
_slit = cq.Workplane(obj=cq.Solid.makeCylinder(_r_chan, _s_g0 - _s_g1,
                              cq.Vector(_Qxf + _nxf*_s_g1, _Qyf + _nyf*_s_g1, _zmf),
                              cq.Vector(_nxf, _nyf, 0)))
box = box.cut(_slit)

# ---------------- seat of the spring ----------------
from parameters import spring_axis, s_spring_axis
Qx, Qy, nx, ny, _zm_spring = spring_axis()
# The fixed end sits at R_seat_spring_box, that is exactly one fitted spring
# beyond the side of the arm. It used to be at r 107.5, which left 1.3 mm to a
# spring 12.8 long; and the boss, 26 long, stuck three and a half millimetres
# out of the outer wall. Now the seat is close to the wall and the boss is
# short: it starts from the seat and just reaches it.
s_along_axis = s_spring_axis

S0 = s_along_axis(D["R_seat_spring_box"])
# The spring axis lies on the mid-plane of the arm plate, not at -6. That -6
# was the mid-plane of a thickening on the arm that served no purpose (see
# solids_arm.py) and has been removed; centred on the plate, the spring pushes
# in line with the section instead of two millimetres off it.
zm = _zm_spring

p0 = (Qx+nx*S0, Qy+ny*S0, zm)
travel, th_cup = D["Travel_preload"], D["Th_cup_spring"]
# The boss starts one travel BEFORE the nominal seat. Starting it at the seat,
# the pocket dug further back found no material to dig and the mouth stayed
# where the boss was: the spring cup, pushed in to increase the preload, came
# out of the guide instead of sliding in it. Measured: towards the arm there
# was zero travel.
pb = (Qx+nx*(S0-travel), Qy+ny*(S0-travel), zm)
# The boss is no longer just long enough to reach the wall: it must hold, in a
# row, the pocket of the spring cup, a bottom of ASA, and the seat of the
# grub's heat-set insert. Measured: between the bottom of the pocket and the
# outer wall there were 5.91 mm and the insert wants 8.6, so the seat would
# have broken into the pocket by two point seven millimetres. Now the boss is
# the longer of the two - the one that reaches the wall and the one that holds
# the row - so if one day the spring seat moves inwards the boss comes back in
# by itself instead of staying proud for ever.
L_row = (2*travel+th_cup) + D["Dp_seat_insert_M4"] + D["Th_retain_insert_M4"]
L_boss = max(s_along_axis(Ro) - (S0-travel) + 1.0, L_row)
R_BOSS = 7.5
box = box.union(cyl(R_BOSS, L_boss, pb, (nx, ny, 0)))           # boss out to the wall

# ---------------- the rib of the spring boss ----------------
# The boss is a cylinder LYING in the middle of the compartment, and the box
# prints with its floor on the bed: its lower half is an overhanging roof that
# wants supports, and under it there is nothing for them to grow from but the
# floor, twenty-seven millimetres lower.
#
# Instead of supporting it, it is filled. Under the cylinder two 45 degree
# faces - tangent to it, closed to a point - carry the material down to a
# vertical rib that goes down to the floor; above the cylinder the same rib
# rises up to the roof of the compartment. No face goes below 45 degrees, so
# in that orientation everything prints from solid.
#
# And it is not only a matter of printing: the boss is the point on which the
# spring presses permanently with 22.3 N, and it was attached to the box only
# by the end that touches the outer wall. Now it is tied to the floor and to
# the vault too, that is it unloads onto the whole section of the shell
# instead of onto one end. The sliced part shows the room for it: below and
# above there is space and nothing else passes there.
_ang_spring = math.degrees(math.atan2(ny, nx))
_sn = D["Th_rib_boss_spring"]/2
_sa_n, _sb_n = S0 - travel, (S0 - travel) + L_boss
_c45 = R_BOSS/math.sqrt(2.0)                 # where the 45 degree tangent touches
_prof_n = [(-_c45, zm - _c45), (_c45, zm - _c45), (0.0, zm - R_BOSS*math.sqrt(2.0))]
_flat = [(-_sn, ZT), (_sn, ZT), (_sn, Qsp + W), (-_sn, Qsp + W)]


def _along_spring(sol):
    """From the local frame of the spring (x along the axis, y across) to the
    plane of the design. Written once: hand-written angles have already cost a
    boss placed five degrees out of position, on the bracket."""
    return (sol.rotate(cq.Vector(0, 0, 0), cq.Vector(0, 0, 1), _ang_spring)
            .translate(cq.Vector(Qx, Qy, 0)))


_rib = (cq.Workplane("YZ").workplane(offset=_sa_n).polyline(_flat).close()
         .extrude(_sb_n - _sa_n))
_rib = _rib.union(cq.Workplane("YZ").workplane(offset=_sa_n).polyline(_prof_n)
                    .close().extrude(_sb_n - _sa_n))
box = box.union(_along_spring(_rib)
                .intersect(inside(AM0, AM1, Ri, 0.0, ZT, (Qsp + W) - ZT)))


# The pocket is no longer just the guide of the spring: the spring cup slides
# in it. The grub pushed with its Ø4 tip directly on the last coil, which is a
# one-millimetre wire: it would have dug into it, and at every turn of
# adjustment it would have rubbed it and loaded it in torsion instead of in
# compression. Now the grub pushes on the back of the spring cup, and the
# spring sees a flat face and a spigot that keeps it on axis, as on the other
# side on the arm.
#
# The pocket starts one travel BEFORE the nominal position: so the preload can
# be increased beyond the nominal, not only slackened. As long as the travel,
# plus the spring cup, plus the travel on the other side.
pt = (Qx+nx*(S0-travel), Qy+ny*(S0-travel), zm)
box = box.cut(cyl(D["D_seat_spring_box"]/2, 2*travel+th_cup, pt, (nx, ny, 0)))
box = box.cut(cyl(2.05, L_boss+2, p0, (nx, ny, 0)))              # M4 hole of the grub

# ---------------- seat of the grub's heat-set insert ----------------
# The 4.1 hole is a clearance, not a thread: the grub would just slide in
# there, while the spring pushes against it with 22.3 N. The thread is in an
# M4 heat-set insert, planted at the mouth of the boss, on the side the grub
# is screwed in from. Beyond the insert the hole stays a clearance: the grub
# screws into the insert and then runs on free up to the spring cup.
#
# The two dimensions that matter are of the inserts of the reference build,
# measured with the caliper: 6.3 outside and 8.1 long. They are bigger than the
# most common M4,
# which is around 5.6 - whoever has different ones changes D_out_insert_M4 and
# L_insert_M4 and all the rest follows.
#
# The hole is narrower than the insert ON PURPOSE, by three and a half tenths:
# melting, it must plant itself in the plastic, not slip into it. And the seat
# is deeper than the insert ON PURPOSE, by half a millimetre: flush, the
# insert would push the molten plastic to the bottom instead of letting it
# flow back.
# THE INSERT IS PLANTED FROM INSIDE, not from outside. The direction is not
# indifferent: the spring pushes the spring cup, the spring cup pushes the
# grub and the grub unloads onto the insert TOWARDS THE OUTSIDE, that is in
# the direction in which the brass comes out of the wall it was put into.
# Planted from outside, those 22.3 N pulled for the whole life of the machine
# in the direction of pull-out. Planted from inside, the same force presses it
# against the outer wall, which stays whole except for the passage of the
# grub: it works in compression.
#
# The iron gets there through the pocket of the spring cup, which is Ø9.6
# coaxial: that is why between the pocket and the seat there is no longer any
# bottom: a bottom there would be the wall that blocks the tool's way. The
# plastic that used to be around it now lies all on the outer side.
s_end = (S0-travel) + L_boss                      # outer face of the boss
_s_mouth = s_end - D["Th_retain_insert_M4"]      # outer face of the insert
p_mouth = cq.Vector(Qx+nx*_s_mouth, Qy+ny*_s_mouth, zm)
towards = cq.Vector(-nx, -ny, 0)                    # towards the inside of the box
box = box.cut(cq.Workplane(obj=cq.Solid.makeCylinder(
    D["D_hole_insert_M4"]/2, D["Dp_seat_insert_M4"], p_mouth, towards)))
# The lead-in looks INWARDS, because that is where the insert comes from. It
# starts half a millimetre beyond the mouth, in the air: a coplanar cone leaves
# splinters.
_s_entry = _s_mouth - D["Dp_seat_insert_M4"]        # inner mouth of the seat
p_entry = cq.Vector(Qx+nx*_s_entry, Qy+ny*_s_entry, zm)
box = box.cut(cq.Workplane(obj=cq.Solid.makeCone(
    D["D_leadin_insert_M4"]/2 + 0.5, D["D_hole_insert_M4"]/2,
    D["Dp_leadin_insert_M4"] + 0.5, p_entry + towards*0.5, -towards)))

# ---------------- the slot of the sensor cable in the roof ----------------
# The sensor cable enters the compartment through the roof. It used to be a
# hole at r 110, and it wanted the bare cable: an already crimped connector did
# not go through. Now it is an OPEN SLOT on the inner edge of the roof, at
# r 86: the cable slips into it sideways, connector included. The open
# edge faces the collar, so the cable is put in the slot BEFORE bringing the
# box up, and with the box fitted the collar closes the slot and holds it.
#
# It is long, and not by choice: the cable arrives from the bracket almost
# flat, and to go down into the compartment without bending below its minimum
# radius it crosses the roof obliquely. The bottom of the slot is where the
# cable leaves the roof.
#
# Countersunk above and below, along the whole edge: a cable resting on a
# sharp edge of printed ASA gets stripped there, after months. The countersink
# is made with a row of cones along the slot, which together make a
# continuous chamfer.
_av = D["Ang_opening_cable_box"]
_rv, _smv = D["D_opening_cable_box"]/2, D["Ch_opening_cable"]
_r_slot = (Ri - 2.0, D["R_opening_cable_box"])
_ua = (math.cos(math.radians(_av)), math.sin(math.radians(_av)))
_na = (-_ua[1], _ua[0])
_p_sl = [(_ua[0]*_r_slot[0] + _na[0]*sg*_rv, _ua[1]*_r_slot[0] + _na[1]*sg*_rv) for sg in (-1, 1)]
_p_sl += [(_ua[0]*_r_slot[1] + _na[0]*sg*_rv, _ua[1]*_r_slot[1] + _na[1]*sg*_rv) for sg in (1, -1)]
box = box.cut(cq.Workplane("XY").workplane(offset=Qsp-1).polyline(_p_sl).close().extrude(W+2))
box = box.cut(cq.Workplane("XY").workplane(offset=Qsp-1).center(*pol(_r_slot[1], _av))
              .circle(_rv).extrude(W+2))
_n_cones = int((_r_slot[1] - _r_slot[0])/0.5) + 1
for _k in range(_n_cones):
    _rk = _r_slot[0] + (_r_slot[1] - _r_slot[0])*_k/(_n_cones - 1)
    _pk = pol(_rk, _av)
    for _z0, _r0, _r1 in ((Qsp+W-_smv, _rv, _rv+_smv), (Qsp, _rv+_smv, _rv)):
        box = box.cut(cq.Workplane(obj=cq.Solid.makeCone(
            _r0, _r1, _smv, cq.Vector(_pk[0], _pk[1], _z0), cq.Vector(0, 0, 1))))

# ---------------- the head: USB and GX12 ----------------
# The USB socket of the XIAO comes flush with the outer face. The slot is OPEN
# TOWARDS THE FLOOR: the board goes in from the floor together with the panel,
# and the socket must be able to rise inside the wall instead of having to go
# through it. Below the socket the slot is closed by a tab of the panel.
_gu = D["Cl_usb"]
# The slot carries the panel's extra clearance too: the TAB rises into it,
# which is the last fit the panel makes going in, and its clearance was
# Cl_panel like all the others. Measuring after widening the outline and the
# ears, the narrowest point had moved right here.
box = box.cut(slot_st(E.S_USB, E.USB_L + 2*_gu + 2*D["Cl_panel_box"],
                       ZT - 1.0, E.Z_USB[1] + _gu,
                       E.T_HEAD_IN - 1.0, E.T_HEAD_OUT + 1.0,
                       (E.USB_H + 2*_gu + 2*D["Cl_panel_box"])/2))
# and below the socket one pitch more towards the back, for the arm going in
# (electronics.EXT_SLOT_BACK, the why is there): up to the top of the
# panel's tongue plus the clearance it rises with
_w_slot = E.USB_L + 2*_gu + 2*D["Cl_panel_box"]
box = box.cut(cq.Workplane(obj=cq.Solid.makeBox(
    E.EXT_SLOT_BACK + 1.0, E.T_HEAD_OUT - E.T_HEAD_IN + 2.0,
    (E.Z_USB[0] - _gu + D["Cl_panel_box"]) - (ZT - 1.0),
    cq.Vector(E.S_USB + _w_slot/2 - 1.0, E.T_HEAD_IN - 1.0, ZT - 1.0)
).rotate(cq.Vector(0, 0, 0), cq.Vector(0, 0, 1), E.A_BOARD)))
# Here was the GROOVE FOR THE XIAO'S BOARD: the board went into the head by
# 0.97 mm - as much as the socket sticks out beyond the edge, less the
# thickness of the wall - and a niche as wide as it was dug, open towards the
# floor. 18.58 wide against the 9.74 of the socket's slot, it left two 4.4 mm
# recesses at the sides of the panel's tower.
#
# REMOVED: the board of the reference build is sanded down on purpose in that
# area and no longer goes into the wall. The head is solid again at the sides of the socket, which is also
# the face the shell of the right-angle plug rests on. To be put back only if
# the board is changed or no longer sanded: the sign to watch is the
# interpenetration between the head and the envelope of the XIAO, which the
# maker's model draws whole.

# The GX12, above the XIAO. The hole runs along t, that is perpendicular to
# the head.
#
# It is NOT a plain round hole, and the reason showed up screwing it on: the
# connector TURNED behind the ring nut. The threaded barrel has two
# anti-rotation flats, one per side at 180 degrees, 11.75 from one to the
# other (measured with the caliper). In a round hole they have nothing to bear
# against.
#
# The flats of the hole are ABOVE AND BELOW, not at the sides: in the head the
# tight space is in height - below is the XIAO, above the LED - and two
# horizontal chords remove material exactly where it is least needed. The
# connector goes in both ways, so the orientation is free and is chosen for
# the box.
_gx = E.xy(E.GX12_S, E.T_HEAD_IN - 1.0)
_w_gx = D["W_flats_gx12"] + D["Cl_flats_gx12"] + D["Comp_hole_printing"]
_round_gx = cyl(D["D_hole_gx12"]/2, W + 2.0,
                (_gx[0], _gx[1], E.GX12_Z), (E.V[0], E.V[1], 0))
_slice_gx = (cq.Workplane("XY").workplane(offset=E.GX12_Z - _w_gx/2)
             .center(_gx[0], _gx[1]).rect(60.0, 60.0).extrude(_w_gx))
box = box.cut(_round_gx.intersect(_slice_gx))

# The tab for the tie of the wires, beside the GX12. Profile in the (t, z)
# plane: free edge vertical, H_tab high; lower edge at 45 degrees up to the
# head, so it prints without support. The slot crosses it transversely.
_la, _sa = D["L_tab_tie"], D["Th_tab_tie"]
_z0a, _z1a = E.TAB_Z
_prof = [(E.T_HEAD_IN + 0.5, _z0a - _la - 0.5), (E.T_HEAD_IN - _la, _z0a),
         (E.T_HEAD_IN - _la, _z1a), (E.T_HEAD_IN + 0.5, _z1a)]
_tie_tab = (cq.Workplane("YZ").workplane(offset=E.TAB_S - _sa/2)
           .polyline(_prof).close().extrude(_sa).val()
           .rotate(cq.Vector(0, 0, 0), cq.Vector(0, 0, 1), E.A_BOARD))
_slot = cq.Workplane(obj=cq.Solid.makeBox(
    _sa + 2.0, D["H_slot_tie_head"], D["W_slot_tie_head"],
    cq.Vector(E.TAB_S - _sa/2 - 1.0, E.TAB_SLOT_T - D["H_slot_tie_head"]/2,
              E.TAB_SLOT_Z - D["W_slot_tie_head"]/2))
    .rotate(cq.Vector(0, 0, 0), cq.Vector(0, 0, 1), E.A_BOARD))
box = box.union(cq.Workplane(obj=_tie_tab)).cut(_slot)

# The status LED, above the GX12.
_led = E.xy(E.LED_S, E.T_HEAD_IN - 1.0)
box = box.cut(cyl(D["D_hole_led"]/2, W + 2.0, (_led[0], _led[1], E.LED_Z), (E.V[0], E.V[1], 0)))

# ---------------- the opening of the panel ----------------
# The panel closes an opening in the floor and carries the board: it is the
# service opening the compartment lacked. The whole floor is not removed,
# because the box prints right on it (assessment on the branch
# vano-elettronica-motore-3: without the floor 831 mm2 of first layer would
# remain).
#
# Flush with the floor, with a STOP on the outer half of the thickness: the
# panel cannot go into the compartment, and the screws hold it from the other
# side. The stop is not there on the side of the skirt, where there is no
# floor, and it must not eat into the back: everything stops at its inner
# face.
_bt = D["Stop_panel"]
_inside_back = inside(AM0, AM1, 0.5, W, ZT - 2.0, 14.0)
_rb = D["D_boss_panel"]/2

# The RAISES of the two ears. In the zones of the screws the panel is
# Th_panel_screws thick and not half a wall, so its step in the box is as deep:
# and there the floor was 2.5, all of it. So the box must RAISE its own floor
# in those zones, otherwise the step becomes a hole and the bosses of the
# screws are left without a roof to grow from.
#
# The raise is the outline of the ear widened by a wall on the sides that
# border material of the box - they are the ones that hold up the roof - and
# not widened on the one facing the opening, where beyond there is nothing to
# grow from. It is cut inside the skirt: further in than it there is the
# collar, and a raise ending up in it would be an interpenetration.
_inside_skirt = cq.Workplane("XY").workplane(offset=ZT - 2.0).circle(E.R_SKIRT[0]).extrude(20.0)
for _s0, _s1, _t0, _t1, _side, _ovl in E.panel_ears():
    # on the free sides the raise widens by a wall, which is the low wall that
    # holds up the roof; on the inner side instead it DRAWS BACK by the
    # overlap, because that millimetre lies inside the opening and no raise
    # belongs there: the guides of the board pass there, and at the first try
    # they ran into it for 23 mm3
    _e = {"s0": -W, "s1": +W, "t0": -W, "t1": +W}
    _e[_side] = -_ovl if _side in ("s1", "t1") else +_ovl
    box = box.union(rect_st(_s0 + _e["s0"], _s1 + _e["s1"],
                                  _t0 + _e["t0"], _t1 + _e["t1"],
                                  E.Z_FLOOR_TOP, (E.Z_SCREWS + W) - E.Z_FLOOR_TOP)
                    .intersect(_inside_back).cut(_inside_skirt)
                    .cut(beyond_head(E.T_HEAD_OUT)))


# The cuts of the opening are kept aside: the column of the front ear at 71.1
# degrees, which comes down right above here, has to redo them too. The ears
# are joined AFTERWARDS, and a cut already made does not cut what comes after:
# without this list the column closed again 109 mm3 of the panel's place, and
# the panel would no longer have come out of the floor.
# The opening is dug WIDER than the panel by Cl_panel_box per side, and the
# clearance is all added on this side: the panel stays the one of before, so
# that a panel already printed still fits. Two tenths per side were right on
# paper - measured on the solids they made 0.199, that is the nominal - and
# nil in the hand: over eighty-five millimetres of part that tenth and a half
# is eaten by the shrinkage. The panel centres nothing: what holds it in
# position is the three screws in their inserts.
_cb = D["Cl_panel_box"]
# The cut-out of the back must be widened too, otherwise on that side the
# extra clearance does not arrive: the panel is cut at Ro - W - Cl_panel and
# the opening at Ro - W, so there the clearance IS Cl_panel and widening the
# rectangle changes nothing - the back trims the cut. Measured: after widening
# only the rectangles, the minimum distance was still 0.199 in three points,
# all on the back. The wall stays W - Cl_panel_box thick in that band.
_inside_back_pan = inside(AM0, AM1, 0.5, W - _cb, ZT - 2.0, 14.0)
PANEL_CUTS = [
    rect_st(E.OP_S[0] - _cb, E.OP_S[1] + _cb, E.OP_T[0] - _cb, E.OP_T[1] + _cb,
                  ZT - 1.0, W + 2.0).intersect(_inside_back_pan),
    rect_st(E.OP_S[0] - _cb, E.OP_S[1] + _bt + _cb,
                  E.OP_T[0] - _bt - _cb, E.OP_T[1] + _bt + _cb,
                  ZT - 1.0, E.Z_STOP - (ZT - 1.0)).intersect(_inside_back_pan),
]
# the two ears, dug down to Z_SCREWS and not to half thickness. Here too the
# extra clearance is dug on the FREE sides - the same ones on which the panel
# had already been made smaller - and not on the one with which the ear is
# welded to the body of the panel, where there is no fit to widen.
for _s0, _s1, _t0, _t1, _side, _ovl in E.panel_ears():
    _e = {"s0": -_cb, "s1": +_cb, "t0": -_cb, "t1": +_cb}
    _e[_side] = 0.0
    _tg = rect_st(_s0 + _e["s0"], _s1 + _e["s1"],
                        _t0 + _e["t0"], _t1 + _e["t1"],
                        ZT - 1.0, E.Z_SCREWS - (ZT - 1.0))
    PANEL_CUTS.append(_tg.intersect(_inside_back_pan) if _side == "t1" else _tg)
# THE CHANNEL OF THE IRON to the three panel inserts, from the floor up to the
# face the insert is planted from (Z_SCREWS). The M3 insert n.2 sits at r 124.4
# and the pocket of its ear is cut back by the back wall, whose inner face is
# at Ro - (W - Cl_panel_box): the foot of that wall stood 3.1 mm from the axis
# for the 4.6 mm between the floor and the mouth, and the tip - Ø8, 8.5 with
# its clearance - met 16 mm3 of it (check_insert_access). The panel
# was never in the way: the insert is planted with the panel off, and the wall
# is part of the box itself. The panel is NOT changed - one already printed
# must keep fitting - so the channel is scooped into the wall from inside, leaving it
# Ro - r_insert - (D_tip_iron + Cl_tip_iron)/2 thick there (1.35 mm) with the
# outer face untouched. It is cut for all three screws and not for "the one
# near the wall": at n.1 and n.3 it removes nothing today, and if a screw
# moves, its channel moves with it.
for _s, _t in E.panel_screws():
    _xv, _yv = E.xy(_s, _t)
    PANEL_CUTS.append(
        cq.Workplane("XY").workplane(offset=ZT - 1.0).center(_xv, _yv)
        .circle((D["D_tip_iron"] + D["Cl_tip_iron"])/2)
        .extrude(E.Z_SCREWS - (ZT - 1.0)))
# ---------------- the web at the head, between the skirt and the wheel ------
# A wall here stiffens the structure. Beside the head, between the outer face of
# the skirt and the wheel body, the box had a gap from the floor up to the
# collar flange: the head wall stopped at the skirt, and the skirt was the
# only thing tying the head to the collar. The web fills that corner: along
# the head plane from the wheel to the skirt, back along the skirt for
# L_rib_head_skirt, and a straight edge from there to the wheel. Radially it
# stops Cl_rib_head_body short of the wheel body; it goes half a millimetre
# into the skirt, and up to the underside of the collar flange.
# Built before the panel cuts, so the panel opening is carved out of it too.
def _on_head(r, t):
    return E.xy(math.sqrt(r*r - t*t), t)
_rw0 = D["D_body"]/2 + D["Cl_rib_head_body"]
_rw1 = E.R_SKIRT[0] + 0.5
_tw0, _tw1 = E.T_HEAD_OUT, E.T_HEAD_OUT - D["L_rib_head_skirt"]
# up to the underside of the collar flange and not into it: half a millimetre
# of overlap there was counted by the audit as box and collar welding outside
# the skin of the shell. Touching is enough - the count of solids below says
# whether it fused.
_zw1 = -D["Th_flange_collar"]
_head_web = (cq.Workplane("XY").workplane(offset=ZT)
          .moveTo(*_on_head(_rw0, _tw0)).lineTo(*_on_head(_rw1, _tw0))
          .threePointArc(_on_head(_rw1, (_tw0 + _tw1)/2), _on_head(_rw1, _tw1))
          .close().extrude(_zw1 - ZT)
          .cut(cq.Workplane("XY").workplane(offset=ZT - 1.0).circle(_rw0).extrude(_zw1 - ZT + 2.0)))
box = box.union(_head_web)
print("web between head, skirt and wheel: r %.1f..%.1f, t %.1f..%.1f, z %.1f..%.1f, %.2f cm3"
      % (_rw0, _rw1, _tw1, _tw0, ZT, _zw1, _head_web.val().Volume()/1000))

# ---------------- the chamfers of the inner wall ----------------
# INSIDE: a ring of 45 degree fillet material on the floor against the wall,
# Chamfer high and wide. OUTSIDE: the same chamfer taken off, parallel to the
# inside one, so that round the corner the wall keeps its thickness: the outer
# leg is C + (2 - sqrt 2) W, which puts the outer slope exactly W from the
# inner one.
#
# WHERE THEY RUN: only between the motor and the ear of the panel by the head
# (they stop a little before the motor, and leave no points by the panel
# insert). Following the motor's outline, the first version left
# the chamfer notched into its silhouette and, at the head, running into the
# pocket of the ear, where it left thin points. Both ends are READ FROM THE
# SOLIDS: the motor end is the furthest the motor's exclusion reaches into the
# band of the chamfers, the other the nearest the ear's cuts reach into it.
#
# HOW THEY END: not square, but fading out on a ramp at the chamfer's own
# angle. At a distance s along the wall from the end the chamfer stands s
# high; the outer ramp runs W*sqrt(2) lower than the inner one, so that on the
# ramp too the wall is W thick across.
_C = D["L_chamfer_wall_inner_floor"]
_L_out = _C + (2.0 - math.sqrt(2.0))*W
_ZTf = ZT + W
# the motor's exclusion: past the outer face of the wall, and down through the
# floor - the silhouette starts at the bottom of the motor, above the floor
_excl = _motor_silhouette(max(D["Cl_entry_motor"] + W*math.sqrt(2.0),
                           D["Cl_wall_inner_motor"] + W) + 0.5)
_excl = _excl.union(_excl.translate((0, 0, -20.0)))
# the band the chamfers live in, short of the inner chamfer's foot by 1 mm:
# the panel opening grazes the foot along its middle, and that is not an end
_band = sett(AM0, AM1, RP0 - 1.0, RP1 + _C - 1.0, ZT - 1.0, _L_out + 3.0)
def _angles(w):
    return [math.degrees(math.atan2(v.Y, v.X)) for v in w.val().Vertices()]
_a_lo = max(_angles(_excl.intersect(_band)))
_ears = PANEL_CUTS[2]
for _tg in PANEL_CUTS[3:]:
    _ears = _ears.union(_tg)
_a_hi = min(a for a in _angles(_ears.intersect(_band)) if a > _a_lo)


def _ramp(a, towards, z0):
    """Keep what is s ahead of the end at angle `a` (on the side `towards`,
    +1 or -1) and at most s above z0: a half-space bounded by a plane at 45
    degrees."""
    ar = math.radians(a)
    t = cq.Vector(-math.sin(ar)*towards, math.cos(ar)*towards, 0.0)
    rad = cq.Vector(math.cos(ar), math.sin(ar), 0.0)
    p0 = cq.Vector(RP1*math.cos(ar), RP1*math.sin(ar), z0)
    n = (t + cq.Vector(0, 0, -1)).normalized()
    return cq.Workplane(cq.Plane(origin=p0, xDir=rad, normal=n)).rect(600, 600).extrude(300)


_sector_ch = sett(_a_lo, _a_hi, RP0 - 1.0, RP0 + _L_out + 2.0, ZT - 2.0, _L_out + 4.0)
_chamfer_in = (cq.Workplane(obj=cq.Solid.makeCone(RP1 + _C, RP1, _C, cq.Vector(0, 0, _ZTf)))
              .cut(cq.Workplane(obj=cq.Solid.makeCylinder(RP1 - 0.5, _C + 1.0, cq.Vector(0, 0, _ZTf - 0.5))))
              .intersect(_sector_ch).intersect(_keep(W)).cut(beyond_head(E.T_HEAD_IN))
              .intersect(_ramp(_a_lo, +1, _ZTf)).intersect(_ramp(_a_hi, -1, _ZTf)))
_z_out = _ZTf - W*math.sqrt(2.0)
_chamfer_out = (cq.Workplane(obj=cq.Solid.makeCone(RP0 + _L_out + 0.5, RP0, _L_out + 0.5, cq.Vector(0, 0, ZT - 0.5)))
               .cut(cq.Workplane(obj=cq.Solid.makeCylinder(RP0 - 0.5, _L_out + 2.0, cq.Vector(0, 0, ZT - 1.0))))
               .intersect(_sector_ch).intersect(_keep(W)).cut(beyond_head(E.T_HEAD_IN))
               .intersect(_ramp(_a_lo, +1, _z_out)).intersect(_ramp(_a_hi, -1, _z_out)))
box = box.union(_chamfer_in).cut(_chamfer_out)
print("chamfers of the inner wall: from %.1f to %.1f degrees, %.0f inside and %.1f outside, ramps at 45 degrees"
      % (_a_lo, _a_hi, _C, _L_out))

for _tg in PANEL_CUTS:
    box = box.cut(_tg)

# ...AND FROM THE RAMP TO THE HEAD, A STRAIGHT CUT. Past the ramp at
# the panel end the floor ran on as a tongue to the head: a triangle in plan
# between the ramp's foot on the wall, the wall's corner at the head and the
# head's corner by the ear. It goes, on a 45 degree plane through the line
# - from the ramp's foot on the wall to the head's corner by the ear, on
# the floor - rising towards the wheel axis: nothing at the ramp, the width
# of the tongue at the head. Both ends are read from the solid, at the floor:
# the ramp's foot is the floor vertex on the wall's face nearest _a_hi from
# below, the head's corner the floor vertex on the head plane outside the wall.
def _on_head(v):
    a = math.radians(E.A_BOARD)
    return abs(-math.sin(a)*v.X + math.cos(a)*v.Y - E.T_HEAD_OUT) < 0.05


_vf = [v for v in box.val().Vertices() if abs(v.Z - ZT) < 1e-3]
_foot = [v for v in _vf if abs(math.hypot(v.X, v.Y) - RP0) < 0.05
          and _a_hi - 5.0 < math.degrees(math.atan2(v.Y, v.X)) < _a_hi + 0.5]
_corner_t = [v for v in _vf if _on_head(v) and math.hypot(v.X, v.Y) > RP0 + 1.0]
if not _foot or not _corner_t:
    raise SystemExit("tongue at the head: cannot find the foot of the ramp (%d) or the corner "
                     "of the head (%d) on the floor" % (len(_foot), len(_corner_t)))
_P3 = max(_foot, key=lambda v: math.atan2(v.Y, v.X))
_H2 = min(_corner_t, key=lambda v: math.hypot(v.X, v.Y))
_d = cq.Vector(_H2.X - _P3.X, _H2.Y - _P3.Y, 0.0).normalized()
_m = cq.Vector(-_d.y, _d.x, 0.0)
if _m.dot(cq.Vector(-_P3.X, -_P3.Y, 0.0)) < 0:
    _m = _m.multiply(-1.0)                             # towards the wheel axis
_nn = (_m - cq.Vector(0, 0, 1)).normalized()
_tongue = (cq.Workplane(cq.Plane(origin=(_P3.X, _P3.Y, ZT), xDir=_d, normal=_nn))
           .rect(200.0, 200.0).extrude(60.0)
           .intersect(sett(math.degrees(math.atan2(_P3.Y, _P3.X)), AM1 + 5.0, RP0 - 10.0,
                           RP0 + 10.0, ZT - 1.0, 15.0))
           .cut(beyond_head(E.T_HEAD_OUT)))
box = box.cut(_tongue)
print("tongue at the head: removed along the line from (%.1f, %.1f) to (%.1f, %.1f), plane at 45 degrees"
      % (_P3.X, _P3.Y, _H2.X, _H2.Y))


# The bosses of the screws, with the M3 insert. The insert is planted FROM
# OUTSIDE, from the face of the stop, and not from inside: from inside it
# cannot be reached, because above the bosses the compartment is closed and the
# mouth of the panel is too narrow for the iron (the section shows it). The
# price is the hold: the screw pulls the insert towards its
# mouth, that is in the direction in which it pulls out, instead of pressing it
# onto the bottom of the hole. For a panel carrying a board it is enough.
# Above the insert the narrow hole remains, for the tip of the screw.
# The bosses grow from the roof of the step, which now sits at Z_SCREWS and no
# longer at half wall: the dimension is one, and boss, seat and lead-in follow
# it.
Z_PANEL_BOSSES = E.Z_SCREWS + D["L_insert_M3"] + 1.0
for _s, _t in E.panel_screws():
    _x, _y = E.xy(_s, _t)
    box = box.union(cq.Workplane("XY").workplane(offset=E.Z_SCREWS).center(_x, _y)
                    .circle(_rb).extrude(Z_PANEL_BOSSES - E.Z_SCREWS)
                    .intersect(inside(AM0, AM1, 0.5, 0.01, ZT, 60.0)))
    box = box.cut(cq.Workplane("XY").workplane(offset=E.Z_SCREWS - 0.01).center(_x, _y)
                  .circle(D["D_hole_insert_M3"]/2).extrude(D["L_insert_M3"] + 0.5))
    box = box.cut(cq.Workplane("XY").workplane(offset=ZT - 1.0).center(_x, _y)
                  .circle(1.7).extrude(Z_PANEL_BOSSES - 0.8 - (ZT - 1.0)))
    # the lead-in, born half a millimetre outside the face as for the other seats
    box = box.cut(cq.Workplane(obj=cq.Solid.makeCone(
        D["D_leadin_insert_M3"]/2 + 0.5, D["D_hole_insert_M3"]/2,
        D["Dp_leadin_insert_M3"] + 0.5,
        cq.Vector(_x, _y, E.Z_SCREWS - 0.5), cq.Vector(0, 0, 1))))


# ---------------- ears fastening to the collar: THEY NO LONGER EXIST --------
# Here stood the six ears - three at the front and three at the back - that
# went over the flanges of the collar and screwed into them, plus the columns
# that carried the front ones down to the floor and the fillets to the wall.
# They took the 22.3 N of the spring and the 680 N mm moment that followed.
#
# Now there is nothing left to fasten: box and collar are the
# same part and the material carries that load. With them three defects go at
# once - the box that did not pass over the screw of the pivot (it was a
# PATH defect, and without sliding it on there is no path), the ear of the
# collar that snapped while sliding it on, and the ten chances of getting a
# screw wrong in assembly (5 M3 screws + 5 heat-set inserts).

# ---------------- spring cup ----------------
# It sits between the grub and the spring, and does three jobs the grub alone
# did not do. It spreads: the Ø4 tip pressed on the last coil, a one-millimetre
# wire, and on ASA it would have dug in until the preload was lost. It
# decouples: turning, the grub rubbed the coil and gave it torsion instead of
# compression, that is it screwed and unscrewed the spring while being
# adjusted. And it centres: the spigot goes into the inner diameter of the
# spring exactly like the spigot on the arm, so the spring is held on axis at
# both ends instead of at one only.
#
# The dish on the back is narrower than the grub: it is the tip that finds the
# centre, not the assembler. And it is a cone, not a flat bottom, because on a
# flat bottom the spring cup could still wander sideways.
_rs, _rc = D["D_cup_spring"]/2, D["D_dish_grub"]/2
_axis = cq.Vector(nx, ny, 0)
_orig = cq.Vector(Qx+nx*S0, Qy+ny*S0, zm)
cup = cq.Solid.makeCylinder(_rs, th_cup, _orig, _axis)
cup = cup.fuse(cq.Solid.makeCylinder(D["D_spigot_spring"]/2, D["Proj_spigot_spring"],
                                       _orig, -_axis))
cup = cup.cut(cq.Solid.makeCone(_rc, 0.0, _rc,
                                  _orig + _axis*th_cup, -_axis))
cup = cq.Workplane(obj=cup.clean())
cq.exporters.export(cup, OUT+"spring_cup.step")
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
