teoteo/Wheelly/(commit log)

2026-09-28 Wheelly 0.1 — first public release
    A motorised filter wheel built around a manual one: 3D-printed parts clamped
    on the wheel you already own, a NEMA14 friction drive, an AS5600 magnetic
    encoder, a XIAO ESP32-S3 on perfboard, its firmware, and an INDI driver for
    Ekos. Guides: https://teoteo.github.io/Wheelly/
2026-09-28 Wheelly 0.1.1
    Three fixes, firmware and INDI driver; mechanics unchanged.
    - Firmware: following the guide's order (USB first, then 12 V), moves could
    be wrong until a `diag` was sent, because the motor driver had been
    configured at boot, before its 12 V arrived, and was never configured again.
    The firmware now checks the driver before every leg and reconfigures it when
    its supply appears after boot or after a reset.
    - INDI driver: when the wheel's USB port vanished (cable pulled, wheel reset),
    the driver kept talking to a dead port. It now notices, says so once in the
    log, and reconnects by itself through /dev/serial/by-id when the wheel comes
    back.
    - INDI driver: an empty fil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
    [dialog.cpp, firmware_bench.cpp, mechanics.h, mechanics_esp32.cpp, mechanics_esp32.h, panel_texts.py, panel_texts_it.py]
2026-09-29 README: the discarded prototypes under Support the project
2026-09-29 INDI proposal: to_indi.py and the driver's INDI page; panel guide fix
    - driver/indi-wheelly/upstream/to_indi.py produces the copy for INDI's tree
    (driver, CMake block, drivers.xml entry, documentation), with the version
    read from CMakeLists.txt; upstream/doc/index.md is the page INDI requires.
    - The driver sources are checked whole against INDI's astyle options;
    wheelly.cpp reformatted in two lines.
    - Panel guide: the Protocol field said the driver accepts only 1; it now says
    it accepts only the version it was built for.
    [panel_texts.py, panel_texts_it.py, test_driver_standalone.py]
2026-09-29 INDI driver English only; panel guide with English labels in both languages
    - The driver's texts are English sentences written in the code, as in every
    INDI driver: the translation layer and the Language property are gone, so
    the copy proposed to INDI and this driver are the same files.
    - The panel guide stays bilingual: the Italian page shows the same pictures
    and the labels as they appear on screen, and explains them in Italian.
    - The driver's page for indilib/drivers-docs (upstream/doc/) and
    to_indi.py --docs to produce it.
    - firmware.md section 13: what is translated and what is not, and why.
2026-09-29 Magnet sweep: CSV from the driver, drawn by the sweep viewer
    - The INDI driver writes the sweep's samples to a CSV file and draws nothing:
    plot.cpp/plot.h and the plot BLOB property are gone.
    - The sweep viewer, https://teoteo.github.io/Wheelly/tools/sweep.html: one
    self-contained page, also usable saved and opened offline; several sweeps
    drawn over each other to compare a before and an after; English and Italian.
    - The panel guide shows the reference wheel's sweeps before and after centring
    the sensor, drawn by the viewer from the two measured files in
    driver/indi-wheelly/doc/sweeps/.
    [2026-09-29_19-05-06_wheelly_sweep.csv, 2026-09-29_19-08-24_wheelly_sweep.csv]
2026-09-29 INDI driver: the executable is indi_wheelly_wheel
    INDI names every filter wheel's executable ..._wheel. The name is set once in
    driver/indi-wheelly/CMakeLists.txt (WHEELLY_EXECUTABLE) and everything else
    derives from it. Installing over an older version leaves /usr/bin/indi_wheelly
    behind, unused: delete it (the driver's README says so).
2026-10-10 The presentation video on the landing page; the AS5600 module in the model
    - docs: the presentation video (youtu.be/iueh7m_XIAk) on the landing page,
    right under the lede, embedded from youtube-nocookie.com so no cookie is
    set until play; the cleaning video (youtu.be/Sq2n5chqD-E) linked from the
    README and from the guide's grip step.
    - CAD: the AS5600 module enters the model as a bought envelope, so the
    checks see it; the sensor figures of chapter 12 redrawn with it.
    - export_print.py: print files on their bed face, exported on demand.
    - Driver: an unused member removed, and clang's unused-private-field made
    an error here too, as in INDI's macOS CI.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
